Serpopovici163/HYDRA_HARDWARE/connector_type_and_what_board_has_them.txt

Picoblade connectors (all connector types should only be used for one pinout to avoid issues from being able to connect the wrong things together)

2p --> V4 NAV (ACT BUS) AND V4 RECOVERY (SFTY SWITCH)
3p -->
4p --> V4 POWER (CELL SENSE)
5p --> V4 POWER (EMAG+INH SW)
6p --> V4 RECOVERY (PYRO)
7p -->* V4 LINK (AUX RADIO)
8p -->* V4 LINK (AUX BATT + ETH)
9p -->
