Serpopovici163/HYDRA_HARDWARE/HYDRA_V4_POWER/STM32G473RET6_PINOUT.xlsx

 |  |  |  |  |  |  |  | HYDRA_V4_POWER
PIN NUM | PIN NAME | SPI | UART | CAN | ADC | GPIO | MAX V | SERCOM I/O | ANALOG I/O | GPIO
2 | PC13 |  |  |  |  | X | 5 |  | INT_VCC_V_SENSE
8 | PC0 |  | LPUART1_RX |  | X | X | 5 |  | INT_3V3_V_SENSE
9 | PC1 |  | LPUART1_TX |  | X | X | 3.6 |  | M2_I_SENSE
10 | PC2 |  |  |  | X | X | 5 |  | M1_I_SENSE
11 | PC3 |  |  |  | X | X | 3.6 |  | M1_V_SENSE
12 | PA0 |  |  |  | X | X | 3.6 |  | M2_V_SENSE
13 | PA1 |  |  |  | X | X | 3.6 |  | M1_OC_FAULT
14 | PA2 |  | USART2_TX |  | X | X | 5 |  | M3_I_SENSE
17 | PA3 |  | USART2_RX |  | X | X | 3.6 |  |  | MCU_R_LED
18 | PA4 | SPI1/3_NSS |  |  | X | X | 3.6 |  |  | MCU_G_LED
19 | PA5 | SPI1_SCLK |  |  | X | X | 3.6
20 | PA6 | SPI1_MISO |  |  | X | X | 3.6
21 | PA7 | SPI1_MOSI |  |  | X | X | 3.6
22 | PC4 |  | USART1_TX |  | X | X | 5 |  | 3V3_V_SENSE
23 | PC5 |  | USART1_RX |  | X | X | 3.6 |  | 5V_V_SENSE
24 | PB0 |  |  |  | X | X | 3.6
25 | PB1 |  |  |  | X | X | 3.6
26 | PB2 |  |  |  | X | X | 3.6
30 | PB10 |  | USART3_TX |  |  | X | 3.6 |  |  | ADC_nRST
33 | PB11 |  | USART3_RX |  | X | X | 3.6 |  | LS_IMON_0
34 | PB12 | SPI2_NSS |  | FDCAN2_RX | X | X | 3.6 | ADC_nCS
35 | PB13 | SPI2_SCLK |  | FDCAN2_TX | X | X | 3.6 | TCAN1146_SCLK
36 | PB14 | SPI2_MISO |  |  | X | X | 3.6 | TCAN1146_MISO
37 | PB15 | SPI2_MOSI |  |  | X | X | 3.6 | TCAN1146_MOSI
38 | PC6 |  |  |  | X | X | 5 |  |  | TCAN1146_nCS
39 | PC7 |  |  |  | X | X | 5
40 | PC8 |  |  |  | X | X | 5 |  |  | LS_PG_0
41 | PC9 |  |  |  | X | X | 5 |  | LS_IMON_1
42 | PA8 |  |  | FDCAN3_RX | X | X | 5 |  |  | LS_PG_1
43 | PA9 |  |  |  | X | X | 5 |  |  | LS_PG_2
44 | PA10 | SPI2_MISO | USART1_RX |  |  | X | 5 |  | LS_IMON_2
45 | PA11 | SPI2_MOSI |  | FDCAN1_RX |  | X | 5 | TCAN1146_RX
46 | PA12 |  |  | FDCAN1_TX |  | X | 5 | TCAN1146_TX
49 | PA13 | SWDIO |  |  |  |  | 5
50 | PA14 | SWCLK |  |  |  |  | 5
51 | PA15 | SPI1/3_NSS | USART2_RX | FDCAN3_TX |  | X | 5 |  |  | EMAG
52 | PC10 | SPI3_SCLK | USART3/4_TX |  |  | X | 5 |  |  | FORCE ON
53 | PC11 | SPI3_MISO | USART3/4_RX |  |  | X | 5 |  |  | CUR_TRIP_RST
54 | PC12 | SPI3_MOSI | UART5_TX |  |  | X | 5 |  |  | M3_INH
55 | PD2 |  | UART5_RX |  |  | X | 5 |  |  | M2_INH
56 | PB3 | SWO |  |  |  |  | 5
57 | PB4 | SPI1/3_MISO | USART2_RX | FDCAN3_TX |  | X | 5 |  |  | STAT_nPG
58 | PB5 | SPI1/3_MOSI |  | FDCAN2_RX |  | X | 5 | TCAN330_RX
59 | PB6 |  | USART1_TX | FDCAN2_TX |  | X | 5 | TCAN330_TX
60 | PB7 |  | USART1_RX |  |  | X | 5 |  |  | 3V3_EN
61 | PB8 |  | USART3_RX | FDCAN1_RX |  | X | 5 |  |  | 5V_EN
62 | PB9 |  | USART3_TX | FDCAN1_TX |  | X | 5 |  |  | M1_INH
