Serpopovici163/HYDRA_HARDWARE/HYDRA_V4_NAV/STM32H730_PINOUT.xlsx

PIN NUM | PIN NAME | SDMMC1 | SDMMC2 | DCMI | ADC | GPIO | HYDRA_V4_NAV
1 | PE2 |  |  |  |  | X | BARO_SCLK
2 | PE3 |  |  |  |  | X | BARO0_nCS
3 | PE4 |  |  | D4 |  | X | BARO1_nCS
4 | PE5 |  |  | D6 |  | X | BARO_MISO
5 | PE6 |  |  | D7 |  | X | BARO_MOSI
6 | VBAT |  |  |  |  | X
7 | PC13 |  |  |  |  | X | ACT_PWR_INH
8 | OSC32_IN |  |  |  |  | X
9 | OSC32_OUT |  |  |  |  | X
10 | VSS |  |  |  |  | X
11 | VDD |  |  |  |  | X
12 | OSC_IN |  |  |  |  | X
13 | OSC_OUT |  |  |  |  | X
14 | nRST |  |  |  |  | X
15 | PC0 |  |  |  | X | X | NAV_G_LED
16 | PC1 |  | CK |  | X | X | NAV_R_LED
17 | PC2_C |  |  |  | X | X
18 | PC3_C |  |  |  | X | X | 3V3_V_SENSE
19 | VSSA |  |  |  |  | X
20 | VREF+ |  |  |  |  | X
21 | VDDA |  |  |  |  | X
22 | PA0 |  | CMD |  | X | X | MCU_G_LED
23 | PA1 |  |  |  | X | X | MCU_R_LED
24 | PA2 |  |  |  | X | X
25 | PA3 |  |  |  | X | X
26 | VSS |  |  |  |  | X
27 | VDD |  |  |  |  | X
28 | PA4 |  |  | HSYNC | X | X | IMU1_nCS
29 | PA5 |  |  |  | X | X | IMU_SCLK
30 | PA6 |  |  | PIXCLK | X | X | IMU_MISO
31 | PA7 |  |  |  | X | X | IMU_MOSI
32 | PC4 |  | CKIN |  | X | X | ACT_PWR_V_SENSE
33 | PC5 |  |  |  | X | X | ACT_PWR_IMON
34 | PB0 |  |  |  | X | X | 3V3_IMON
35 | PB1 |  |  |  | X | X | HYDRA_VCC_V_SENSE
36 | PB2 |  |  |  |  | X
37 | PE7 |  |  |  |  | X
38 | PE8 |  |  |  |  | X
39 | PE9 |  |  |  |  | X
40 | PE10 |  |  |  |  | X
41 | PE11 |  |  |  |  | X
42 | PE12 |  |  |  |  | X
43 | PE13 |  |  |  |  | X
44 | PE14 |  |  |  |  | X
45 | PE15 |  |  |  |  | X
46 | PB10 |  |  |  |  | X
47 | PB11 |  |  |  |  | X
48 | VCAP |  |  |  |  | X
49 | VSS |  |  |  |  | X
50 | VDD |  |  |  |  | X
51 | PB12 |  |  |  |  | X | TCAN_nCS
52 | PB13 | D0 |  |  |  | X | TCAN_SCLK
53 | PB14 |  | D0 |  |  | X | TCAN_MISO
54 | PB15 |  | D1 |  |  | X | TCAN_MOSI
55 | PD8 |  |  |  |  | X
56 | PD9 |  |  |  |  | X
57 | PD10 |  |  |  |  | X
58 | PD11 |  |  |  |  | X
59 | PD12 |  |  | D12 |  | X | CAN3_RX
60 | PD13 |  |  | D13 |  | X | CAN3_TX
61 | PD14 |  |  |  |  | X
62 | PD15 |  |  |  |  | X
63 | PC6 | D0DIR/D6 | D6 | D0 |  | X
64 | PC7 | D123DIR/D7 | D7 | D1 |  | X
65 | PC8 | D0 |  | D2 |  | X | SD_D0
66 | PC9 | D1 |  | D3 |  | X | SD_D1
67 | PA8 |  |  |  |  | X
68 | PA9 |  |  | D0 |  | X
69 | PA10 |  |  | D1 |  | X
70 | PA11 |  |  |  |  | X | CAN1_RX
71 | PA12 |  |  |  |  | X | CAN1_TX
72 | SWDIO/PA13 |  |  |  |  | X
73 | VCAP |  |  |  |  | X
74 | VSS |  |  |  |  | X
75 | VDD |  |  |  |  | X
76 | SWCLK/PA14 |  |  |  |  | X
77 | PA15 |  |  |  |  | X
78 | PC10 | D2 |  | D8 |  | X | SD_D2
79 | PC11 | D3 |  | D4 |  | X | SD_D3
80 | PC12 | CK |  | D9 |  | X | SD_CK
81 | PD0 |  |  |  |  | X
82 | PD1 |  |  |  |  | X
83 | PD2 | CMD |  | D11 |  | X | SD_CMD
84 | PD3 |  |  | D5 |  | X | IMU0_ODR
85 | PD4 |  |  |  |  | X | IMU0_Nrst
86 | PD5 |  |  |  |  | X | SD_CD
87 | PD6 |  | CK | D10 |  | X | IMU0_nCS
88 | PD7 |  | CMD |  |  | X | IMU1_INT1
89 | SWO/PB3 |  | D2 |  |  | X
90 | PB4 |  | D3 |  |  | X | IMU1_INT2
91 | PB5 |  |  | D10 |  | X | CAN2_RX
92 | PB6 |  |  | D5 |  | X | CAN2_TX
93 | PB7 |  |  | VSYNC |  | X | GPS_nRST
94 | BOOT
95 | PB8 | CKIN/D4 | D4 | D6 |  | X | GPS_RX
96 | PB9 | CDIR/D5 | D5 | D7 |  | X | GPS_TX
97 | PE0 |  |  | D2 |  | X | GPS_ENABLE
98 | PE1 |  |  | D3 |  | X
99 | VSS |  |  |  |  | X
100 | VDD |  |  |  |  | X
