Serpopovici163/HYDRA_HARDWARE/HYDRA_V4_RECOVERY/STM32H730_PINOUT.xlsx

PIN NUM | PIN NAME | SDMMC1 | SDMMC2 | DCMI | ADC | GPIO | HYDRA_V4_RECOVERY
1 | PE2 |  |  |  |  | X
2 | PE3 |  |  |  |  | X
3 | PE4 |  |  | D4 |  | X
4 | PE5 |  |  | D6 |  | X
5 | PE6 |  |  | D7 |  | X
6 | VBAT |  |  |  |  | X
7 | PC13 |  |  |  |  | X
8 | OSC32_IN |  |  |  |  | X
9 | OSC32_OUT |  |  |  |  | X
10 | VSS |  |  |  |  | X
11 | VDD |  |  |  |  | X
12 | OSC_IN |  |  |  |  | X
13 | OSC_OUT |  |  |  |  | X
14 | nRST |  |  |  |  | X
15 | PC0 |  |  |  | X | X | VCC_V_SENSE
16 | PC1 |  | CK |  | X | X
17 | PC2_C |  |  |  | X | X
18 | PC3_C |  |  |  | X | X | 5V_V_SENSE
19 | VSSA |  |  |  |  | X
20 | VREF+ |  |  |  |  | X
21 | VDDA |  |  |  |  | X
22 | PA0 |  | CMD |  | X | X | 3V3_V_SENSE
23 | PA1 |  |  |  | X | X | PYRO_PWR_V_SENSE
24 | PA2 |  |  |  | X | X | MAIN_V_SENSE
25 | PA3 |  |  |  | X | X | DROGUE_V_SENSE
26 | VSS |  |  |  |  | X
27 | VDD |  |  |  |  | X
28 | PA4 |  |  | HSYNC | X | X | CAM_HSYNC
29 | PA5 |  |  |  | X | X | BUZZER
30 | PA6 |  |  | PIXCLK | X | X | CAM_PIXCLK
31 | PA7 |  |  |  | X | X | DROGUE_I_SENSE
32 | PC4 |  | CKIN |  | X | X | MAIN_I_SENSE
33 | PC5 |  |  |  | X | X | POST_SW_PYRO_V_SENSE
34 | PB0 |  |  |  | X | X | 3V3_IMON
35 | PB1 |  |  |  | X | X | 5V_IMON
36 | PB2 |  |  |  |  | X | MCU_R_LED
37 | PE7 |  |  |  |  | X | MCU_G_LED
38 | PE8 |  |  |  |  | X
39 | PE9 |  |  |  |  | X
40 | PE10 |  |  |  |  | X
41 | PE11 |  |  |  |  | X
42 | PE12 |  |  |  |  | X
43 | PE13 |  |  |  |  | X
44 | PE14 |  |  |  |  | X
45 | PE15 |  |  |  |  | X
46 | PB10 |  |  |  |  | X
47 | PB11 |  |  |  |  | X
48 | VCAP |  |  |  |  | X
49 | VSS |  |  |  |  | X
50 | VDD |  |  |  |  | X
51 | PB12 |  |  |  |  | X
52 | PB13 | D0 |  |  |  | X
53 | PB14 |  | D0 |  |  | X | SD_D0
54 | PB15 |  | D1 |  |  | X | SD_D1
55 | PD8 |  |  |  |  | X
56 | PD9 |  |  |  |  | X
57 | PD10 |  |  |  |  | X
58 | PD11 |  |  |  |  | X
59 | PD12 |  |  | D12 |  | X
60 | PD13 |  |  | D13 |  | X
61 | PD14 |  |  |  |  | X
62 | PD15 |  |  |  |  | X
63 | PC6 | D0DIR/D6 | D6 | D0 |  | X | CAM_D0
64 | PC7 | D123DIR/D7 | D7 | D1 |  | X | CAM_D1
65 | PC8 | D0 |  | D2 |  | X | CAM_D2
66 | PC9 | D1 |  | D3 |  | X | CAM_D3
67 | PA8 |  |  |  |  | X
68 | PA9 |  |  | D0 |  | X
69 | PA10 |  |  | D1 |  | X | CAM_nINTRQ
70 | PA11 |  |  |  |  | X
71 | PA12 |  |  |  |  | X
72 | SWDIO/PA13 |  |  |  |  | X
73 | VCAP |  |  |  |  | X
74 | VSS |  |  |  |  | X
75 | VDD |  |  |  |  | X
76 | SWCLK/PA14 |  |  |  |  | X
77 | PA15 |  |  |  |  | X
78 | PC10 | D2 |  | D8 |  | X
79 | PC11 | D3 |  | D4 |  | X | CAM_D4
80 | PC12 | CK |  | D9 |  | X
81 | PD0 |  |  |  |  | X
82 | PD1 |  |  |  |  | X | CAM_nPWRDN
83 | PD2 | CMD |  | D11 |  | X | CAM_nRST
84 | PD3 |  |  | D5 |  | X | CAM_D5
85 | PD4 |  |  |  |  | X
86 | PD5 |  |  |  |  | X
87 | PD6 |  | CK | D10 |  | X | SD_CK
88 | PD7 |  | CMD |  |  | X | SD_CMD
89 | SWO/PB3 |  | D2 |  |  | X | SD_D2
90 | PB4 |  | D3 |  |  | X | SD_D3
91 | PB5 |  |  | D10 |  | X | DROGUE_TRIG
92 | PB6 |  |  | D5 |  | X | MAIN_TRIG
93 | PB7 |  |  | VSYNC |  | X
94 | BOOT
95 | PB8 | CKIN/D4 | D4 | D6 |  | X | CAM_D6
96 | PB9 | CDIR/D5 | D5 | D7 |  | X | CAM_D7
97 | PE0 |  |  | D2 |  | X | IMU_nRST
98 | PE1 |  |  | D3 |  | X | IMU_ODR
99 | VSS |  |  |  |  | X
100 | VDD |  |  |  |  | X
