Serpopovici163/HYDRA_HARDWARE/HYDRA_V4_LINK/Project Outputs for Free Documents/BOM/Bill of Materials-HYDRA_V4_LINK.xlsx

Line # | Quantity | Name | Description | Designator | Revision ID | Revision State | Revision Status | Manufacturer 1 | Manufacturer Part Number 1 | Manufacturer Lifecycle 1 | Supplier 1 | Supplier Part Number 1 | Supplier Unit Price 1 | Supplier Subtotal 1
 | 54 | 100n, TBD, 10u, 3.3n, 6.8n, 22n, 10n, 4.7n, 4.7u, 30p, 1u, 18p | LARGE PADS, 0402 CAP, CHANGE COMMENT TO MATCH REAL P/N | C1, C2, C3, C4, C5, C6, C8, C14, C16, C17, C18, C19, C20, C24, C25, C27, C28, C29, C30, C31, C32, C33, C34, C35, C36, C37, C38, C39, C40, C41, C42, C43, C44, C45, C46, C47, C48, C49, C50, C51, C52, C53, C54, C55, C56, C57, C58, C59, C61, C62, C63, C64, C65, C68 |  | Unknown server |  | Taiyo Yuden | EMK105BJ105KV-F | Volume Production | LCSC | C92755 | 0.0034 | 0.34
 | 3 | C0805C106K8PACTU | CAP CER 10UF 10V X5R 0805 | C7, C9, C10 |  | Unknown server |  | KEMET | C0805C106K8PACTU | Volume Production | Mouser | 80-C0805C106K8P | 0.12 | 0.36
 | 3 | GRM21BR60J226ME39L | Chip Multilayer Ceramic Capacitors for General Purpose, 0805, 22uF, X5R, 15%, 20%, 6.3V | C11, C12, C13 |  | Unknown server |  | Murata | GRM21BR60J226ME39L | Volume Production | Newark | 24R6338 | 0.126 | 0.378
 | 2 | 4TPE100MZB | Molded Tantalum Polymer Capacitor 100uF 20% 4V life 1000Hours SMD 1411 | C15, C26 |  | Unknown server |  | Panasonic | 4TPE100MZB | Volume Production | Newark | 88Y9311 | 1.04 | 2.08
 | 2 | GRM21BR61E226ME44L | Chip Multilayer Ceramic Capacitors for General Purpose, 0805, 22uF, X5R, 15%, 20%, 25V | C21, C22 |  | Unknown server |  | Murata | GRM21BR61E226ME44L | Volume Production | Farnell | 1907510 | 0.07904 | 0.39518
 | 1 | TMK212BBJ106KG-T | Multilayer Ceramic Capacitor 10uF 25V X5R 10% SMD 0805 T/R | C23 |  | Unknown server |  | Taiyo Yuden | TMK212BBJ106KG-T | Volume Production | Newark | 92T9713 | 0.16 | 0.16
 | 3 | MM5Z3V3T1G | Zener Voltage Regulator, 500 mW, 2-Pin SOD-523, Pb-Free, Tape and Reel | D1, D4, D6 |  | Unknown server |  | ON Semiconductor | MM5Z3V3T1G | Volume Production | Newark | 09R9519 | 0.03 | 0.09
 | 4 | 150066RG54050 | Led, Red/Grn, 180Mcd/230Mcd, 624Nm/525Nm Rohs Compliant: Yes | D2, D3, D5, D7 |  | Unknown server
 | 3 | MF-PSML150/12-2 | MF-PSML150/12-2 | F1, F2, F3 |  | Unknown server |  | Bourns | MF-PSMF050X-2 | Volume Production | Newark | 87W5970 | 0.267 | 0.801
 | 1 | BLM15AG121SN1D | Chip Ferrite Bead, 0402, 120Ω @ 100MHz, 0.19Ω, 25%, 550mA | FB1 |  | Unknown server |  | Murata | BLM15AG121SN1D | Volume Production | Digikey | 490-1005-1-ND | 0.1 | 0.1
 | 1 | BLM15PX601SN1D | Chip Ferrite Bead, 0402, 600Ω @ 100MHz, 0.23Ω, 25%, 900mA | FB2 |  | Unknown server |  | Murata | BLM15PX601SN1D | Volume Production | Digikey | 490-9657-1-ND | 0.1 | 0.1
 | 2 | SFML-110-02-L-D-A | Board Connector, 20 Contact(s), 2 Row(s), Female, Straight, 0.05 inch Pitch, Surface Mount Terminal, Locking, Black Insulator, Socket | J1, J2 |  | Unknown server |  | Samtec | SFML-110-02-L-D-A | Volume Production
 | 2 | TFML-110-02-L-D-A | Board Connector, 20 Contact(s), 2 Row(s), Male, Straight, Surface Mount Terminal | J3, J4 |  | Unknown server |  | Samtec | TFML-110-02-L-D-A | Volume Production | Avnet | TFML-110-02-L-D-A | 3.24 | 6.49
 | 1 | FTSH-105-01-F-D-RA-K | Board Connector, 10 Contact(s), 2 Row(s), Male, Right Angle, 0.05 inch Pitch, Surface Mount Terminal, Locking, Black Insulator | J5 |  | Unknown server |  | Samtec | FTSH-105-01-F-D-RA-K | Volume Production | Avnet | FTSH-105-01-F-D-RA-K | 2.61 | 2.61
 | 1 | SM08B-GHS-TB(LF)(SN);- | Connector Header, GH Series, 8 Position, 1.25mm, 30-26 AWG, 50V, Surface Mount, Right Angle, Solder, Locking Ramp | J6 |  | Unknown server |  | JST | SM08B-GHS-TB(LF)(SN);- |  | LCSC | C265111 | 0.2261 | 1.13
 | 2 | IHLP1616ABER1R0M01 | Fixed Inductors Commercial High Saturation Series SMT 1uH 4A 52.5mΩ 20% | L1, L2 |  | Unknown server |  | Vishay Dale | IHLP1616ABER1R0M01 | Volume Production | Newark | 45M5848 | 0.391 | 0.782
 | 1 | BSS138W-7-F | N-Channel Enhancement Mode Mosfet, 50 V, 200 mA, -55 to 150 degC, 6-Pin SOT-323, RoHS, Tape and Reel | Q1 |  | Unknown server |  | Diodes | BSS138W-7-F | Volume Production | Future Electronics | 6104898 | 0.161 | 0.161
 | 2 | DMG1013UW-7 | P-Channel Enhancement Mode MOSFET, 310 mW, 20 V, -55 to 150 degC, 3-Pin SOT-323, RoHS, Tape and Reel | Q2, Q4 |  | Unknown server |  | Diodes | DMG1013UW-7 | Volume Production | Mouser | 621-DMG1013UW-7 | 0.24 | 0.48
 | 2 | SSM6N7002KFU,LF | Transistor MOSFET Array Dual N-CH 60V 300mA 6-Pin SOT-363 Emboss T/R | Q3, Q5 |  | Unknown server |  | Toshiba | SSM6N7002KFU,LF | Volume Production | Mouser | 757-SSM6N7002KFULF | 0.2 | 0.4
 | 86 | 1M, 680k, 1k, 68k, 110k, 10k, 100k, 330, 560, 2.7k, 24k, 49.9 1%, 33, 75 1%, 150 1%, 12.4k 1%, 10 1%, 120 | Resistor | R1, R2, R3, R4, R5, R6, R7, R8, R9, R10, R11, R12, R13, R14, R15, R16, R17, R18, R19, R20, R21, R22, R23, R24, R25, R26, R27, R28, R29, R30, R31, R32, R33, R34, R35, R36, R37, R38, R39, R40, R41, R42, R43, R44, R46, R47, R50, R54, R55, R56, R57, R58, R59, R60, R61, R62, R63, R64, R65, R66, R67, R68, R69, R70, R71, R72, R73, R74, R75, R76, R77, R78, R79, R81, R82, R83, R84, R85, R90, R91, R93, R95, R96, R97, R98, R101 |  | Unknown server
 | 1 | 473521001 | MicroSD(TM), Pitch 1.1 mm, 8 Position, Height 1.88 mm, -20 to 85 degC, RoHS, Tape and Reel | SD1 |  | Unknown server |  | Molex | 47352-1001 | Volume Production
 | 2 | KXT331LHS | SWITCH TACTILE SPST-NO 0.02A 15V | SW2, SW3 |  | Unknown server |  | ITT C&K | KXT331LHS | Volume Production | Newark | 35AH1369 | 0.213 | 0.426
 | 1 | ALANL100X1-DE12DT | Datacom Transformer, LAN; 10/100 BASE-TX; ETHERNET Application(s), 1CT:1CT | T1 |  | Unknown server |  | Abracon | ALANL100X1-DE12DT | Volume Production | Arrow Electronics | ALANL100X1-DE12DT | 2.18 | 2.18
 | 2 | TPS16412DRCR | 2.7-V to 40-V 152-mΩ 1.8-A eFuse with output power limiting 10-VSON -40 to 125 | U1, U2 |  | Unknown server |  | Texas Instruments | TPS16412DRCR |  | Mouser | 595-TPS16412DRCR | 1.46 | 2.92
 | 1 | BQ24040DSQR | 800 mA, Single-Input, Single Cell Li-Ion Battery Charger with Auto Start. Vovp=6.6 V, 3.5 V, -40 to 85 degC, 10-pin SON (DSQ), Green (RoHS & no Sb/Br) | U3 |  | Unknown server |  | Texas Instruments | BQ24040DSQR | Volume Production | Mouser | 595-BQ24040DSQR | 0.75 | 0.75
 | 2 | ACS711KEXLT-15AB-T | Hall Effect Linear Current Sensor with Overcurrent Fault Output for <100 V Isolation Applications, 3 to 5.5 V, -15.5 to 15.5 A IP, -40 to 125 degC, 12-Pin QFN (EX), RoHS, Tape and Reel | U4, U8 |  | Unknown server |  | Allegro MicroSystems | ACS711KEXLT-15AB-T | Volume Production | Arrow Electronics | ACS711KEXLT-15AB-T | 0.8707 | 1.74
 | 1 | TPS63021DSJR | Switching Regulator, Current-mode, 2A, 2600kHz Switching Freq-Max, PDSO14 | U5 |  | Unknown server |  | Texas Instruments | TPS63021DSJR | Volume Production | Newark | 54AH1637 | 1.12 | 1.12
 | 2 | LM66200DRLR | 1.6-V to 5.5-V, 40-mΩ, 2.5-A, low-IQ, dual ideal diode 8-SOT-5X3 -40 to 125 | U6, U10 |  | Unknown server |  | Texas Instruments | LM66200DRLR |  | LCSC | C3235556 | 0.2954 | 0.5908
 | 1 | AiThinker RA-02 LoRa Module |  | U7 |  | Unknown server
 | 1 | TPS62133RGTR | Buck Step Down Regulator with 3 to 17 V Input and 5 V Output, -40 to 85 degC, 16-Pin QFN (RGT), Green (RoHS & no Sb/Br) | U9 |  | Unknown server |  | Texas Instruments | TPS62133RGTR | Volume Production | Digikey | 296-29937-6-ND | 1.71 | 1.71
 | 1 | W5500 | Ethernet CTLR Single Chip 10Mbps/100Mbps 3.3V 48-Pin LQFP Reel | U11 |  | Unknown server |  | WIZnet | W5500 |  | LCSC | C32843 | 3.14 | 3.14
 | 1 | STM32G473RET6TR | MCU 32-Bit STM32 ARM Cortex-M4 RISC 512KB Flash 1.71V to 3.6V 64-Pin LQFP T/R | U12 |  | Unknown server |  | STMicroelectronics | STM32G473RET6TR | Volume Production | Arrow Electronics | STM32G473RET6TR | 4.81 | 4807.2
 | 1 | TCAN1146DYYRQ1 | Automotive CAN FD transceiver with watchdog, bus diagnostics and partial networking via sele 14-SOT-23-THIN -40 to 150 | U13 |  | Unknown server
 | 1 | TCAN330GDCNR | IC TRANSCEIVER 1/1 SOT23-8 | U15 |  | Unknown server |  | Texas Instruments | TCAN330GDCNR | Volume Production | Digikey | 296-TCAN330GDCNRCT-ND | 2.55 | 2.55
 | 2 | ABM8G-25.000MHZ-18-D2Y-T | Crystal 25MHz ±20ppm (Tol) ±30ppm (Stability) 18pF FUND 60Ω 4-Pin SMD T/R | Y1, Y2 |  | Unknown server |  | Abracon | ABM8G-25.000MHZ-18-D2Y-T |  | Farnell | 2101339 | 0.37256 | 0.74513
 | 1 | ECS-.327-12.5-1210-TR | CRYSTAL 32.7680KHZ 12.5PF SMD | Y3 |  | Unknown server |  | ECS International | ECS-.327-12.5-1210-TR | Volume Production | Digikey | XC2282CT-ND | 1.31 | 1.31
