Serpopovici163/HYDRA_HARDWARE/HYDRA_V4_ASSY/Project Outputs for HYDRA_V4_ASSY/HYDRA_V4_ASSY.xlsx

Line # | Name | Description | Designator | Revision ID | Revision State | Revision Status | ModuleAssembly | Quantity | Manufacturer 1 | Manufacturer Part Number 1 | Manufacturer Lifecycle 1 | Supplier 1 | Supplier Part Number 1 | Supplier Unit Price 1 | Supplier Subtotal 1
 | 0402 CAP | LARGE PADS, 0402 CAP, CHANGE COMMENT TO MATCH REAL P/N | C1, C2, C2_FDCAN_1, C2_FDCAN_2, C3, C4, C5, C6, C7, C8, C9, C10, C11, C12, C13, C14, C15, C16, C17, C18, C19, C20, C21, C22, C23, C24, C25, C26, C27, C28, C29, C30, C31, C32, C33, C34, C35, C36, C37, C38, C39, C40, C41, C42, C42_LS_0, C42_LS_1, C42_LS_2, C43, C44, C45, C46, C47, C48, C49, C50, C51, C52, C53, C54, C55, C56, C57, C58, C59, C60, C61, C62, C63, C64, C65, C68 | CMP-001-00058-1 | Draft | Up to date | HYDRA_V4_POWER.PcbDoc, HYDRA_V4_NAV.PcbDoc, HYDRA_V4_LINK_V2.PcbDoc, HYDRA_V4_RECOVERY.PcbDoc | 254 | Taiyo Yuden | EMK105BJ105KV-F | Volume Production | LCSC | C92755 | 0.0037 | 0.9398
 | C0805C106K8PACTU | CAP CER 10UF 10V X5R 0805 | C7, C9, C10 | CMP-2007-03243-2 | New From Design | Up to date | HYDRA_V4_LINK_V2.PcbDoc | 3 | KEMET | C0805C106K8PACTU | Volume Production | Digikey | 399-C0805C106K8PACTUCT-ND | 0.13 | 0.39
 | GRM21BR61E226ME44L | Chip Multilayer Ceramic Capacitors for General Purpose, 0805, 22uF, X5R, 15%, 20%, 25V | C8, C13, C21, C22 | CMP-2007-03222-3 | New From Design | Up to date | HYDRA_V4_POWER.PcbDoc, HYDRA_V4_LINK_V2.PcbDoc | 6 | Murata | GRM21BR61E226ME44L | Volume Production | Digikey | 490-10749-1-ND | 0.187 | 1.87
 | TMK212BBJ106KG-T | Multilayer Ceramic Capacitor 10uF 25V X5R 10% SMD 0805 T/R | C9, C10, C14, C15, C23 | CMP-14477-000079-3 | New From Design | Up to date | HYDRA_V4_POWER.PcbDoc, HYDRA_V4_LINK_V2.PcbDoc | 9 | Taiyo Yuden | TMK212BBJ106KG-T | Volume Production | Digikey | 587-2985-1-ND | 0.082 | 0.82
 | GRM21BR60J226ME39L | Chip Multilayer Ceramic Capacitors for General Purpose, 0805, 22uF, X5R, 15%, 20%, 6.3V | C11, C12, C13 | CMP-2007-03385-2 | New From Design | Up to date | HYDRA_V4_LINK_V2.PcbDoc | 3 | Murata | GRM21BR60J226ME39L | Volume Production | Future Electronics | 1620103 | 0.2 | 0.6
 | GRM188R60J106ME47D | Chip Multilayer Ceramic Capacitors for General Purpose, 0603, 10uF, X5R, 15%, 20%, 6.3V | C12 | CMP-2006-02792-2 | New From Design | Up to date | HYDRA_V4_RECOVERY.PcbDoc | 1 | Murata | GRM188R60J106ME47D | Volume Production | Mouser | 81-GRM188R60J106ME47 | 0.1 | 0.1
 | 4TPE100MZB | Molded Tantalum Polymer Capacitor 100uF 20% 4V life 1000Hours SMD 1411 | C15, C26 | CMP-05428-001141-1 | New From Design | Up to date | HYDRA_V4_LINK_V2.PcbDoc | 2 | Panasonic | 4TPE100MZB | Volume Production | Arrow Electronics | 4TPE100MZB | 0.2892 | 1.45
 | 150066RG54050 | Led, Red/Grn, 180Mcd/230Mcd, 624Nm/525Nm Rohs Compliant: Yes | D1, D2, D3, D4, D5, D6, D7 | CMP-004-00040-2 | Draft | Up to date | HYDRA_V4_POWER.PcbDoc, HYDRA_V4_NAV.PcbDoc, HYDRA_V4_RECOVERY.PcbDoc, HYDRA_V4_LINK_V2.PcbDoc | 20
 | MM5Z3V3T1G | Zener Voltage Regulator, 500 mW, 2-Pin SOD-523, Pb-Free, Tape and Reel | D1, D3, D4, D6, D7, D8, D9, D10 | CMP-1060-00750-1 | Released | Up to date | HYDRA_V4_LINK_V2.PcbDoc, HYDRA_V4_NAV.PcbDoc, HYDRA_V4_RECOVERY.PcbDoc, HYDRA_V4_POWER.PcbDoc | 15 | onsemi | MM5Z3V3T1G | Volume Production | Newark | 09R9519 | 0.03 | 0.45
 | MMSZ5242BT1G | Zener Voltage Regulator, 500 mW, 2-Pin SOD-123, Pb-Free, Tape and Reel | D2 | CMP-1060-00565-1 | Released | Up to date | HYDRA_V4_POWER.PcbDoc | 2 | onsemi | MMSZ5242BT1G | Volume Production | Newark | 58M9232 | 0.022 | 0.044
 | MBRA140T3G | Schottky Power Rectifier, 2-Pin SMA, Pb-Free, Tape and Reel | D3 | CMP-1055-00320-1 | Released | Up to date | HYDRA_V4_RECOVERY.PcbDoc | 1 | onsemi | MBRA140T3G | Volume Production | Newark | 83H7266 | 0.125 | 0.125
 | 0466005.NR | FUSE BOARD MNT 5A 32VAC/VDC 1206 | F1 | CMP-08605-000032-1 | New From Design | Up to date | HYDRA_V4_NAV.PcbDoc | 1 | Littelfuse | 0466005.NR | Volume Production | Arrow Electronics | 0466005.NR | 0.2973 | 0.2973
 | 0501010.WR | FUSE BOARD MOUNT 10A 32VDC 1206 | F1, F2 | CMP-08605-000084-1 | New From Design | Up to date | HYDRA_V4_POWER.PcbDoc | 4 | Littelfuse | 0501010.WR | Volume Production | Arrow Electronics | 0501010.WR | 0.5465 | 2.19
 | MF-PSMF010X-2 | PTC RESET FUSE 15V 100MA 0805 | F1, F2 | CMP-07400-000017-1 | New From Design | Up to date | HYDRA_V4_RECOVERY.PcbDoc | 2 | Bourns | MF-PSMF010X-2 | Volume Production | Newark | 87W5967 | 0.225 | 0.45
 | MF-PSMF050X-2 | PTC RESET FUSE 6V 500MA 0805 | F1, F2, F3, F7, F8 | CMP-07400-000013-1 | New From Design | Up to date | HYDRA_V4_LINK_V2.PcbDoc, HYDRA_V4_POWER.PcbDoc | 9 | Bourns | MF-PSMF050X-2 | Volume Production | Newark | 87W5970 | 0.267 | 2.4
 | 0603L010YR | PTC RESET FUSE 15V 100MA 0603 | F2, F6 | CMP-08606-000025-1 | New From Design | Up to date | HYDRA_V4_NAV.PcbDoc, HYDRA_V4_RECOVERY.PcbDoc | 2 | Littelfuse | 0603L010YR | Volume Production | Mouser | 576-0603L010YR | 1.22 | 2.44
 | MF-FSMF050X-2 | PTC RESET FUSE 6V 500MA 0603 | F3, F4 | CMP-07400-000010-1 | New From Design | Up to date | HYDRA_V4_RECOVERY.PcbDoc | 2 | Bourns | MF-FSMF050X-2 | Volume Production | Mouser | 652-MFFSMF050X-2 | 0.4 | 0.8
 | 0805L010YR | 0805L010YR PTC Resettable Fuse 0.1A(hold) 0.3A(trip) 15VDC 100A 0.5W 1.5s 1Ohm SMD Solder Pad 0805 T/R | F4 | CMP-00227-00673855-1 | New From Design | Up to date | HYDRA_V4_POWER.PcbDoc | 2 | Littelfuse | 0805L010YR | Volume Production | Newark | 18M4774 | 0.383 | 0.766
 | 0ZCK0010FF2G | PTC RESET FUSE 15V 100MA 0805 | F5, F6 | CMP-16043-000017-1 | New From Design | Up to date | HYDRA_V4_POWER.PcbDoc | 4 | Bel | 0ZCK0010FF2G | Volume Production | Arrow Electronics | 0ZCK0010FF2G | 0.074 | 0.296
 | MF-NSMF012-2 | PTC RESET FUSE 30V 120MA 1206 | F7 | CMP-07400-000025-1 | New From Design | Up to date | HYDRA_V4_RECOVERY.PcbDoc | 1 | Bourns | MF-NSMF012-2 | Volume Production | Newark | 89M6030 | 0.259 | 0.259
 | BLM15AG121SN1D | Chip Ferrite Bead, 0402, 120Ω @ 100MHz, 0.19Ω, 25%, 550mA | FB1 | CMP-0686-00170-4 | New From Design | Up to date | HYDRA_V4_LINK_V2.PcbDoc | 1 | Murata | BLM15AG121SN1D | Volume Production | Newark | 73M9023 | 0.006 | 0.006
 | BLM15PX601SN1D | Chip Ferrite Bead, 0402, 600Ω @ 100MHz, 0.23Ω, 25%, 900mA | FB1, FB2 | CMP-0686-00252-4 | New From Design | Up to date | HYDRA_V4_POWER.PcbDoc, HYDRA_V4_NAV.PcbDoc, HYDRA_V4_RECOVERY.PcbDoc, HYDRA_V4_LINK_V2.PcbDoc | 5 | Murata | BLM15PX601SN1D | Volume Production | Digikey | 490-9657-1-ND | 0.1 | 0.5
 | SFML-110-02-L-D-A | Board Connector, 20 Contact(s), 2 Row(s), Female, Straight, 0.05 inch Pitch, Surface Mount Terminal, Locking, Black Insulator, Socket | J1, J2 | CMP-002-00043-1 | Draft | Up to date | HYDRA_V4_POWER.PcbDoc, HYDRA_V4_NAV.PcbDoc, HYDRA_V4_LINK_V2.PcbDoc, HYDRA_V4_RECOVERY.PcbDoc | 10 | Samtec | SFML-110-02-L-D-A | Volume Production | Digikey | SAM11753-ND | 5.64 | 56.4
 | 205338-0004 | PICO-LOCK 2.0 W/B HEADER ASSY ET | J3 | CMP-04776-000717-1 | New From Design | Up to date | HYDRA_V4_NAV.PcbDoc | 1 | Molex | 205338-0004 | Volume Production | Mouser | 538-205338-0004 | 1.67 | 1.67
 | XT30PW-M |  | J3 | CMP-002-00064-1 | Draft | Up to date | HYDRA_V4_POWER.PcbDoc | 2 | Amass | XT30PW-M | Unknown
 | SM06B-GHS-TB(LF)(SN) | Conn Shrouded Header HDR 6 POS 1.25mm Solder RA Side Entry SMD T/R | J3, J4 | CMP-002-00082-1 | Draft | Up to date | HYDRA_V4_RECOVERY.PcbDoc | 2 | JST | SM06B-GHS-TB(LF)(SN) | Unknown | LCSC | C133065 | 0.1908 | 0.954
 | TFML-110-02-L-D-A | Board Connector, 20 Contact(s), 2 Row(s), Male, Straight, Surface Mount Terminal | J3, J4, J5, J6, J7 | CMP-002-00042-3 | Draft | Up to date | HYDRA_V4_LINK_V2.PcbDoc, HYDRA_V4_POWER.PcbDoc, HYDRA_V4_NAV.PcbDoc, HYDRA_V4_RECOVERY.PcbDoc | 10 | Samtec | TFML-110-02-L-D-A | Volume Production | Arrow Electronics | TFML-110-02-L-D-A | 3.31 | 33.1
 | FTSH-105-01-F-D-RA-K | Board Connector, 10 Contact(s), 2 Row(s), Male, Right Angle, 0.05 inch Pitch, Surface Mount Terminal, Locking, Black Insulator | J5, J6, J11 | CMP-002-00041-5 | Draft | Up to date | HYDRA_V4_LINK_V2.PcbDoc, HYDRA_V4_POWER.PcbDoc, HYDRA_V4_NAV.PcbDoc, HYDRA_V4_RECOVERY.PcbDoc | 5 | Samtec | FTSH-105-01-F-D-RA-K | Volume Production | Avnet | FTSH-105-01-F-D-RA-K | 2.63 | 13.17
 | SM02B-GHS-TB(LF)(SN) | MCU 32-bit LPC1800 ARM Cortex M3 RISC 768KB Flash 3.3V 100-Pin TFBGA Tray | J5, J8 | CMP-002-00083-1 | Draft | Up to date | HYDRA_V4_RECOVERY.PcbDoc, HYDRA_V4_NAV.PcbDoc | 2 | JST | SM02B-GHS-TB(LF)(SN) | Unknown | LCSC | C189893 | 0.1022 | 0.511
 | SM08B-GHS-TB(LF)(SN);- | Connector Header, GH Series, 8 Position, 1.25mm, 30-26 AWG, 50V, Surface Mount, Right Angle, Solder, Locking Ramp | J6 | CMP-002-00079-3 | Draft | Up to date | HYDRA_V4_LINK_V2.PcbDoc | 1 | JST | SM08B-GHS-TB(LF)(SN);- | Unknown | LCSC | C265111 | 0.2964 | 1.48
 | SM05B-GHS-TB(LF)(SN) | Connector Header, GH Series, 5 Position, 1.25mm, Surface Mount, Right Angle, Tin, Natural | J7 | CMP-002-00081-1 | Draft | Up to date | HYDRA_V4_POWER.PcbDoc | 2 | JST | SM05B-GHS-TB(LF)(SN) | Unknown | Mouser | 306-SM05BGHSTBLFSN | 0.42 | 0.84
 | U.FL-R-SMT(10) | CONN U.FL RCPT STR 50 OHM SMD | J7 | CMP-0029-00003-2 | New From Design | Up to date | HYDRA_V4_NAV.PcbDoc | 1 | Hirose | U.FL-R-SMT(10) | Volume Production | Newark | 69AK2346 | 0.884 | 0.884
 | SM04B-GHS-TB(LF)(SN) | Conn Shrouded Header HDR 4 POS 1.25mm Solder RA SMD Reel | J8 | CMP-002-00080-1 | Draft | Up to date | HYDRA_V4_POWER.PcbDoc | 2 | JST | SM04B-GHS-TB(LF)(SN) | Unknown | LCSC | C189895 | 0.1394 | 0.697
 | LQW18AN27NJ00D | Wire Wound RF Inductor 27nH ±5% 440mA 0.21Ω 0603 (1608) | L1 | CMP-06042-013840-1 | New From Design | Up to date | HYDRA_V4_NAV.PcbDoc | 1 | Murata | LQW18AN27NJ00D | Volume Production | Mouser | 81-LQW18AN27NJ00D | 0.11 | 0.11
 | IHLP1212BZER2R2M11 | FIXED IND 2.2UH 3A 46 MOHM SMD | L1, L2 | CMP-02424-000689-1 | New From Design | Up to date | HYDRA_V4_POWER.PcbDoc | 4 | Vishay Dale | IHLP1212BZER2R2M11 | Volume Production | Mouser | 70-IHLP1212BZER2R2M1 | 1.06 | 4.24
 | IHLP1616ABER1R0M01 | Fixed Inductors Commercial High Saturation Series SMT 1uH 4A 52.5mΩ 20% | L1, L2 | CMP-02424-000161-1 | New From Design | Up to date | HYDRA_V4_LINK_V2.PcbDoc | 2 | Vishay Dale | IHLP1616ABER1R0M01 | Volume Production | Arrow Electronics | IHLP1616ABER1R0M01 | 0.5726 | 1.15
 | CMT-8504-100-SMT-TR | 8.5 mm, 5 Vo-p, 100 dB, Surface Mount (SMT), Magnetic Audio Transducer Buzzer | LS1 | CMP-00030-00002-1 | Draft | Up to date | HYDRA_V4_RECOVERY.PcbDoc | 1 | Same Sky | CMT-8504-100-SMT-TR | Volume Production | Mouser | 490-CMT-8504100SMTTR | 1.4 | 1.4
 | SISH615ADN-T1-GE3 | Trans MOSFET P-CH 20V 22.1A 8-Pin PowerPAK 1212 EP T/R | Q1, Q2, Q3, Q4, Q5, Q6, Q7, Q11, Q18, Q19 | CMP-013-00018-2 | Draft | Up to date | HYDRA_V4_POWER.PcbDoc, HYDRA_V4_RECOVERY.PcbDoc | 22
 | BSS138W-7-F | N-Channel Enhancement Mode Mosfet, 50 V, 200 mA, -55 to 150 degC, 6-Pin SOT-323, RoHS, Tape and Reel | Q1, Q2, Q4, Q10, Q12 | CMP-2000-05968-1 | Released | Up to date | HYDRA_V4_LINK_V2.PcbDoc, HYDRA_V4_NAV.PcbDoc, HYDRA_V4_RECOVERY.PcbDoc, HYDRA_V4_POWER.PcbDoc | 6 | Diodes | BSS138W-7-F | Volume Production | Future Electronics | 6104898 | 0.161 | 0.966
 | DMG1013UW-7 | P-Channel Enhancement Mode MOSFET, 310 mW, 20 V, -55 to 150 degC, 3-Pin SOT-323, RoHS, Tape and Reel | Q2, Q4, Q7, Q8, Q9, Q13, Q14, Q17 | CMP-2000-06170-1 | Released | Up to date | HYDRA_V4_LINK_V2.PcbDoc, HYDRA_V4_POWER.PcbDoc, HYDRA_V4_NAV.PcbDoc, HYDRA_V4_RECOVERY.PcbDoc | 14 | Diodes | DMG1013UW-7 | Volume Production | Digikey | DMG1013UW-7DICT-ND | 0.168 | 2.35
 | SSM6N7002KFU,LF | MOSFET 2N-CH 60V 0.3A | Q2, Q9, Q10, Q16 | CMP-35916-000009-1 | New From Design | Up to date | HYDRA_V4_RECOVERY.PcbDoc, HYDRA_V4_POWER.PcbDoc | 7 | Toshiba | SSM6N7002KFU,LF | Volume Production | Arrow Electronics | SSM6N7002KFU,LF | 0.0131 | 0.131
 | SSM6N7002KFU,LF | Transistor MOSFET Array Dual N-CH 60V 300mA 6-Pin SOT-363 Emboss T/R | Q3, Q5 | CMP-006-0005-1 | Draft | Up to date | HYDRA_V4_LINK_V2.PcbDoc | 2 | Toshiba | SSM6N7002KFU,LF | Volume Production | Arrow Electronics | SSM6N7002KFU,LF | 0.0131 | 0.131
 | FDC6327C | Dual N & P-Channel 2.5 V Specified PowerTrench(TM) MOSFET, -55 to 150 degC, 6-Pin SOT-23, RoHS, Tape and Reel | Q15 | CMP-2000-04939-1 | Released | Up to date | HYDRA_V4_POWER.PcbDoc | 2 | onsemi | FDC6327C | Volume Production | Mouser | 512-FDC6327C | 1.26 | 2.52
 | Resistor | Resistor | R1, R2, R3, R3_FDCAN_1, R3_FDCAN_2, R4, R5, R6, R7, R8, R9, R10, R11, R12, R13, R14, R15, R16, R17, R18, R19, R20, R21, R22, R23, R24, R25, R26, R27, R28, R29, R30, R31, R32, R33, R34, R35, R36, R37, R38, R39, R40, R41, R42, R43, R44, R45, R46, R47, R48, R49, R50, R51, R52, R53, R54, R55, R56, R57, R58, R59, R60, R61, R62, R63, R64, R65, R66, R67, R68, R69, R70, R71, R72, R73, R74, R75, R76, R77, R78, R79, R80, R81, R82, R83, R84, R85, R86, R87, R88, R89, R90, R91, R93, R95, R96, R96_LS_0, R96_LS_1, R96_LS_2, R97, R97_LS_0, R97_LS_1, R97_LS_2, R98, R98_LS_0, R98_LS_1, R98_LS_2, R99_LS_0, R99_LS_1, R99_LS_2, R100_LS_0, R100_LS_1, R100_LS_2, R101, R101_LS_0, R101_LS_1, R101_LS_2, R102_LS_0, R102_LS_1, R102_LS_2 | CMP-009-00002-14 | Draft | Up to date | HYDRA_V4_POWER.PcbDoc, HYDRA_V4_NAV.PcbDoc, HYDRA_V4_LINK_V2.PcbDoc, HYDRA_V4_RECOVERY.PcbDoc | 432
 | 0402 JUMPER | READ THE NAME | R17, R46, R48, R82 | CMP-009-00118-2 | Draft | Up to date | HYDRA_V4_NAV.PcbDoc, HYDRA_V4_RECOVERY.PcbDoc | 4
 | WSLP1206R0100FEA | RES 0.01 OHM 1% 1W 1206 | R26 | CMP-2003-04373-2 | Released | Up to date | HYDRA_V4_POWER.PcbDoc | 2 | Vishay Dale | WSLP1206R0100FEA | Volume Production | Newark | 84R1939 | 0.419 | 0.838
 | 47219-2001 | MicroSD Card Connector, Hinge Type, -40 to 85 degC, 8-Pin SMD, RoHS, Tape and Reel | SD1 | CMP-2000-05245-1 | Released | Up to date | HYDRA_V4_RECOVERY.PcbDoc | 1 | Molex | 47219-2001 | Volume Production | Arrow Electronics | 47219-2001 | 0.9028 | 0.9028
 | 473521001 | MicroSD(TM), Pitch 1.1 mm, 8 Position, Height 1.88 mm, -20 to 85 degC, RoHS, Tape and Reel | SD1 | CMP-2000-05848-1 | Released | Up to date | HYDRA_V4_NAV.PcbDoc, HYDRA_V4_LINK_V2.PcbDoc | 2 | Molex | 47352-1001 | Volume Production
 | KXT331LHS | SWITCH TACTILE SPST-NO 0.02A 15V | SW1, SW2, SW3 | CMP-10040-000029-1 | New From Design | Up to date | HYDRA_V4_POWER.PcbDoc, HYDRA_V4_NAV.PcbDoc, HYDRA_V4_RECOVERY.PcbDoc, HYDRA_V4_LINK_V2.PcbDoc | 12 | ITT C&K | KXT331LHS | Volume Production | Newark | 35AH1369 | 0.213 | 2.56
 | ALANL100X1-DE12DT | Datacom Transformer, LAN; 10/100 BASE-TX; ETHERNET Application(s), 1CT:1CT | T1 | CMP-012-00013-1 | Draft | Up to date | HYDRA_V4_LINK_V2.PcbDoc | 1 | Abracon | ALANL100X1-DE12DT | Volume Production | Digikey | 535-ALANL100X1-DE12DTCT-ND | 2.26 | 2.26
 | TPAD6R | Test Point .6mm | TP13 | CMP-00025-2 | Draft | Out of date | HYDRA_V4_NAV.PcbDoc | 1
 | TPS16412DRCR | 2.7-V to 40-V 152-mΩ 1.8-A eFuse with output power limiting 10-VSON -40 to 125 | U1, U2, U3, U11 | CMP-019-00048-3 | Draft | Up to date | HYDRA_V4_LINK_V2.PcbDoc, HYDRA_V4_NAV.PcbDoc, HYDRA_V4_RECOVERY.PcbDoc | 5 | Texas Instruments | TPS16412DRCR | Unknown | Mouser | 595-TPS16412DRCR | 1.46 | 7.3
 | ACS711KEXLT-15AB-T | Hall Effect Linear Current Sensor with Overcurrent Fault Output for <100 V Isolation Applications, 3 to 5.5 V, -15.5 to 15.5 A IP, -40 to 125 degC, 12-Pin QFN (EX), RoHS, Tape and Reel | U1, U2, U4, U8 | CMP-1557-00001-1 | Released | Up to date | HYDRA_V4_POWER.PcbDoc, HYDRA_V4_RECOVERY.PcbDoc, HYDRA_V4_LINK_V2.PcbDoc | 8 | Allegro MicroSystems | ACS711KEXLT-15AB-T | Volume Production | Arrow Electronics | ACS711KEXLT-15AB-T | 0.8707 | 6.97
 | STM32H730VBT6 | IC MCU 32BIT 128KB FLASH 100LQFP | U1, U8 | CMP-12105-000107-1 | New From Design | Up to date | HYDRA_V4_NAV.PcbDoc, HYDRA_V4_RECOVERY.PcbDoc | 2 | STMicroelectronics | STM32H730VBT6 | Volume Production | Arrow Electronics | STM32H730VBT6 | 6.86 | 13.72
 | TCAN330GDCNR | IC TRANSCEIVER 1/1 SOT23-8 | U2_FDCAN_1, U2_FDCAN_2, U9, U10, U15 | CMP-04872-000178-1 | New From Design | Up to date | HYDRA_V4_NAV.PcbDoc, HYDRA_V4_RECOVERY.PcbDoc, HYDRA_V4_POWER.PcbDoc, HYDRA_V4_LINK_V2.PcbDoc | 6 | Texas Instruments | TCAN330GDCNR | Volume Production | Digikey | 296-TCAN330GDCNRCT-ND | 2.55 | 15.3
 | BQ24040DSQR | 800 mA, Single-Input, Single Cell Li-Ion Battery Charger with Auto Start. Vovp=6.6 V, 3.5 V, -40 to 85 degC, 10-pin SON (DSQ), Green (RoHS & no Sb/Br) | U3 | CMP-0321-00456-2 | Released | Up to date | HYDRA_V4_LINK_V2.PcbDoc | 1 | Texas Instruments | BQ24040DSQR | Volume Production | Digikey | 296-37142-1-ND | 0.78 | 0.78
 | TLV1805DBVR | 40V, RAIL-TO-RAIL INPUT, PUSH-PU | U3 | CMP-04896-000098-1 | New From Design | Up to date | HYDRA_V4_POWER.PcbDoc | 2 | Texas Instruments | TLV1805DBVR | Volume Production | Arrow Electronics | TLV1805DBVR | 0.4046 | 0.8092
 | ACS711KEXLT-31AB-T | Hall Effect Linear Current Sensor with Overcurrent Fault Output for <100 V Isolation Applications, 3 to 5.5 V, -31 to 31 A IP, -40 to 125 degC, 12-Pin QFN (EX), RoHS, Tape and Reel | U4 | CMP-1557-00002-1 | Released | Up to date | HYDRA_V4_POWER.PcbDoc | 2 | Allegro MicroSystems | ACS711KEXLT-31AB-T | Volume Production | Arrow Electronics | ACS711KEXLT-31AB-T | 0.6055 | 1.21
 | MMC5633NJL | Magnetoresistive Sensor X, Y, Z Axis 4-WLP (0.85x0.85) | U4 | CMP-010-00014-2 | Draft | Up to date | HYDRA_V4_NAV.PcbDoc | 1 | Memsic | MMC5633NJL | Unknown | Digikey | 1267-MMC5633NJLCT-ND | 0.96 | 0.96
 | IIM-20670 | 6-axis IMU with extended temperature range and high VRE performance | U4, U8 | CMP-010-00029-4 | Draft | Up to date | HYDRA_V4_RECOVERY.PcbDoc, HYDRA_V4_NAV.PcbDoc | 2 | TDK InvenSense | IIM-20670 | Unknown | Arrow Electronics | IIM-20670 | 8.85 | 17.7
 | AP7375-33SA-7 | LDO Regulator Pos 3.3V 0.3A 3-Pin SOT-23 T/R | U5 | CMP-019-00039-1 | Draft | Up to date | HYDRA_V4_POWER.PcbDoc | 2 | Diodes | AP7375-33SA-7 | Unknown | Mouser | 621-AP7375-33SA-7 | 0.25 | 0.5
 | TPS63021DSJR | Switching Regulator, Current-mode, 2A, 2600kHz Switching Freq-Max, PDSO14 | U5 | CMP-019-00052-2 | Draft | Up to date | HYDRA_V4_LINK_V2.PcbDoc | 1 | Texas Instruments | TPS63021DSJR | Volume Production | LCSC | C202140 | 1.54 | 1.54
 | MS561101BA03-50 | Barometric Pressure Sensor, with Stainless Steel Cap, 1.8 to 3.6 V, -45 to 85 degC, 8-Pin QFN, RoHS, Tape and Reel | U5, U9 | CMP-2000-05251-1 | Released | Up to date | HYDRA_V4_RECOVERY.PcbDoc, HYDRA_V4_NAV.PcbDoc | 2 | Measurement Specialties | MS561101BA03-50 | Unknown
 | MCP1824T-1802E/OT | 300 mA, Low Voltage, Low Quiescent Current LDO Regulator, 5-Pin SOT-23, Extended Temperature, Tape and Reel | U6 | CMP-0136-00652-1 | Released | Up to date | HYDRA_V4_RECOVERY.PcbDoc | 1 | Microchip | MCP1824T-1802E/OT | Volume Production | Arrow Electronics | MCP1824T-1802E/OT | 0.5166 | 0.5166
 | TPS62133RGTR | Buck Step Down Regulator with 3 to 17 V Input and 5 V Output, -40 to 85 degC, 16-Pin QFN (RGT), Green (RoHS & no Sb/Br) | U6, U9 | CMP-0323-00146-3 | Released | Up to date | HYDRA_V4_POWER.PcbDoc, HYDRA_V4_LINK_V2.PcbDoc | 3 | Texas Instruments | TPS62133RGTR | Volume Production | Mouser | 595-TPS62133RGTR | 1.71 | 5.13
 | LM66200DRLR | 1.6-V to 5.5-V, 40-mΩ, 2.5-A, low-IQ, dual ideal diode 8-SOT-5X3 -40 to 125 | U6, U10 | CMP-019-00049-1 | Draft | Up to date | HYDRA_V4_LINK_V2.PcbDoc | 2 | Texas Instruments | LM66200DRLR | Unknown | Heisener | LM66200DRLR | 0.3133 | 0.6266
 | TCAN1146DYYRQ1 | Automotive CAN FD transceiver with watchdog, bus diagnostics and partial networking via sele 14-SOT-23-THIN -40 to 150 | U6, U10, U11, U13 | CMP-318-000000-2 | Draft | Up to date | HYDRA_V4_NAV.PcbDoc, HYDRA_V4_RECOVERY.PcbDoc, HYDRA_V4_POWER.PcbDoc, HYDRA_V4_LINK_V2.PcbDoc | 5
 | ADV7280WBCPZ | Color Signal Decoder, CMOS | U7 | CMP-015-00015-1 | Draft | Up to date | HYDRA_V4_RECOVERY.PcbDoc | 1 | Analog Devices | ADV7280WBCPZ | Not Recommended for New Design | Newark | 49AK9075 | 13.64 | 13.64
 | AiThinker RA-02 LoRa Module |  | U7 | CMP-021-00000-1 | Draft | Up to date | HYDRA_V4_LINK_V2.PcbDoc | 1
 | TPS62132RGTR | Buck Step Down Regulator with 3 to 17 V Input and 3.3 V Output, -40 to 85 degC, 16-Pin QFN (RGT), Green (RoHS & no Sb/Br) | U7 | CMP-0323-00152-3 | Released | Up to date | HYDRA_V4_POWER.PcbDoc | 2 | Texas Instruments | TPS62132RGTR | Volume Production | Arrow Electronics | TPS62132RGTR | 1.31 | 2.61
 | SN74LVC1G11DCKR | IC GATE AND 1CH 3-INP SC70-6 | U8 | CMP-0859-00482-4 | New From Design | Up to date | HYDRA_V4_POWER.PcbDoc | 2 | Texas Instruments | SN74LVC1G11DCKR | Volume Production | Mouser | 595-SN74LVC1G11DCKR | 0.17 | 0.34
 | STM32G473RET6TR | MCU 32-Bit STM32 ARM Cortex-M4 RISC 512KB Flash 1.71V to 3.6V 64-Pin LQFP T/R | U9, U12 | CMP-020-00020-2 | Draft | Up to date | HYDRA_V4_POWER.PcbDoc, HYDRA_V4_LINK_V2.PcbDoc | 3 | STMicroelectronics | STM32G473RET6TR | Volume Production
 | ICM-45686 | Ultra High-Performance 6-Axis MEMS Motion Sensor | U10 | CMP-010-00035-1 | Draft | Up to date | HYDRA_V4_NAV.PcbDoc | 1 | TDK InvenSense | ICM-45686 | Unknown | LCSC | C22459454 | 3.67 | 3.67
 | MS580301BA01-00 | MINIATURE ALTIMETER MODULE | U11 | CMP-03338-000001-1 | New From Design | Up to date | HYDRA_V4_NAV.PcbDoc | 1 | TE Connectivity | MS580301BA01-00 | Volume Production | Future Electronics | 2058846 | 20.06 | 20.06
 | W5500 | Ethernet CTLR Single Chip 10Mbps/100Mbps 3.3V 48-Pin LQFP Reel | U11 | CMP-015-0000-2 | Draft | Up to date | HYDRA_V4_LINK_V2.PcbDoc | 1 | WIZnet | W5500 | Unknown | LCSC | C32843 | 2.73 | 2.73
 | AP7375-50SA-7 | Ldo Cmos Lowcurr SOT23 T&r 3K | U12 | CMP-019-00041-1 | Draft | Up to date | HYDRA_V4_POWER.PcbDoc | 2 | Diodes | AP7375-50SA-7 | Unknown | Mouser | 621-AP7375-50SA-7 | 0.25 | 0.5
 | MAX-M10M-00B | Gnss Lcc Rx Mod, Rom, Crystal | U12 | CMP-010-00031-2 | Draft | Up to date | HYDRA_V4_NAV.PcbDoc | 1 | u-blox | MAX-M10M-00B | Unknown | Future Electronics | 6161035 | 14.2 | 14.2
 | LT6000IDCB#TRMPBF | IC OPAMP GP 1 CIRCUIT 6DFN | U13 | CMP-09116-000039-1 | New From Design | Up to date | HYDRA_V4_NAV.PcbDoc | 1 | Analog Devices / Linear Technology | LT6000IDCB#TRMPBF | Volume Production | Newark | 51AK8950 | 2.96 | 2.96
 | LM73100RPWR | 2.7-V TO 23-V, 5.5-A IDEAL DIODE | U13_LS_0, U13_LS_1, U13_LS_2 | CMP-04910-000122-1 | New From Design | Up to date | HYDRA_V4_POWER.PcbDoc | 6 | Texas Instruments | LM73100RPWR | Volume Production | Digikey | 296-LM73100RPWRCT-ND | 1.49 | 8.94
 | ADS130B04QPWRQ1 | Automotive 16-bit, 32-kSPS, four-channel, simultaneous-sampling, delta-sigma ADC 20-TSSOP -40 to 125 | U14 | CMP-015-00014-2 | Draft | Up to date | HYDRA_V4_POWER.PcbDoc | 2 | Texas Instruments | ADS130B04QPWRQ1 | Unknown | Mouser | 595-ADS130B04QPWRQ1 | 6.55 | 13.1
 | TPS259830ONRGER | 2.7-V to 26-V, 2.7-mΩ 18-A integrated hot-swap eFuse with current monitor and blocking FET driver 24-VQFN -40 to 125 | U14 | CMP-019-00050-3 | Draft | Up to date | HYDRA_V4_NAV.PcbDoc | 1 | Texas Instruments | TPS259830ONRGER | Unknown | Mouser | 595-TPS259830ONRGER | 3.81 | 3.81
 | ABM8G-28.63636MHZ-18-D2Y-T | Crystal 28.63636MHz ±20ppm (Tol) ±30ppm (Stability) 18pF FUND 50Ω 4-Pin SMD T/R | Y1 | CMP-27762-014063-1 | New From Design | Up to date | HYDRA_V4_RECOVERY.PcbDoc | 1 | Abracon | ABM8G-28.63636MHZ-18-D2Y-T | Unknown | Mouser | 815-ABM8G-28.6-18D2Y | 0.57 | 0.57
 | ABM8G-25.000MHZ-18-D2Y-T | Crystal 25MHz ±20ppm (Tol) ±30ppm (Stability) 18pF FUND 60Ω 4-Pin SMD T/R | Y1, Y2 | CMP-2000-05733-3 | Released | Up to date | HYDRA_V4_POWER.PcbDoc, HYDRA_V4_LINK_V2.PcbDoc, HYDRA_V4_NAV.PcbDoc, HYDRA_V4_RECOVERY.PcbDoc | 6 | Abracon | ABM8G-25.000MHZ-18-D2Y-T | Unknown | Farnell | 2101339 | 0.38134 | 2.29
 | ECS-.327-12.5-1210-TR | CRYSTAL 32.7680KHZ 12.5PF SMD | Y2, Y3 | CMP-40224-000006-1 | New From Design | Up to date | HYDRA_V4_POWER.PcbDoc, HYDRA_V4_NAV.PcbDoc, HYDRA_V4_LINK_V2.PcbDoc, HYDRA_V4_RECOVERY.PcbDoc | 5 | ECS International | ECS-.327-12.5-1210-TR | Volume Production | Mouser | 520-.327-12.5-1210T | 1.31 | 6.55
