Serpopovici163/HYDRA_HARDWARE/PWR_CALCS.xlsx

Sheet: LM73100
3v3 | R1 | 470 | 470
 | R2 | 25.15050167 | 32.4
 | R3 | 264.0802676 | 270
 | Vin_UV | 3.065079365
 | Vin_OV | 3.432888889
 | R4 | 110
 | R5 | 68
 | V_PG | 3.141176471
 | V_IMON | 1.5
 | I_MAX | 3
 | R_IMON | 2747.252747
5v | R1 | 270 | 270 | R1 | 680 | 470
 | R2 | 6.923076923 | 10 | R2 | 17.43589744 | 10
 | R3 | 83.07692308 | 80.6 | R3 | 209.2307692 | 270
 | Vin_UV | 4.77615894 |  | Vin_UV | 3.214285714
 | Vin_OV | 5.368734491 |  | Vin_OV | 3.333333333
 | R4 | 68
 | R5 | 24
 | V_PG | 4.6
 | V_IMON | 1.5
 | I_MAX | 3
 | R_IMON | 2747.252747
VCC | R1 | 32.4 | 32.4
 | R2 | 1.819251337 | 3.9
 | R3 | 2.598930481 | 2.7
 | Vin_UV | 7.090909091
 | Vin_OV | 17.33333333
 | R4 | 680
 | R5 | 100
 | V_PG | 9.36
 | V_IMON | 1.5
 | I_MAX | 3
 | R_IMON | 2747.252747

Sheet: TPS1641
3v3 |  | 5v |  | vcc |  | ilim resistors |  | imon res
R1 | 540 | R1 | 480 | R1 | 920 | .25a | 39.36k | 199.2k
R2 | 430 | R2 | 200 | R2 | 91 | .5a | 19.68k | 99.8k
 |  |  |  |  |  | .75a | 13.12k | 66.6k
VOVPR | 1.53 | VOVPR | 1.53 | VOVPR | 1.53 | 1a | 9.84k | 49.95k
VOVPF | 1.4 | VOVPF | 1.4 | VOVPF | 1.4 | 1.5a | 6.56k | 33.31k
OVP_RISING | 3.451395349 | OVP_RISING | 5.202 | OVP_RISING | 16.99813187
OVP_FALLING | 3.158139535 | OVP_FALLING | 4.76 | OVP_FALLING | 15.55384615
