Serpopovici163/HYDRA_HARDWARE/0_MISC_CAD/2_SECOND_CERT_ATTEMPT/HYDRA_ASSY/2025_04_26_HYDRA_V4_NAV/HYDRA_V4_NAV.SLDASM

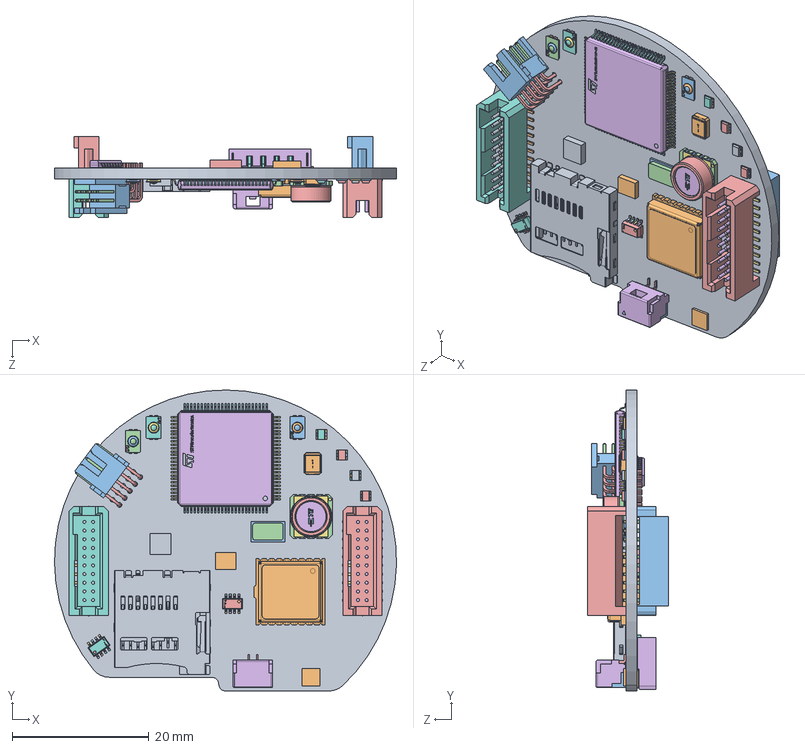
[picture p11: CAD file, 2025-09-30]
0_MISC_CAD/2_SECOND_CERT_ATTEMPT/HYDRA_ASSY/2025_04_26_HYDRA_V4_NAV/HYDRA_V4_NAV.SLDASM
50.0 x 44.0 x 11.8 mm
