Serpopovici163/HYDRA_HARDWARE/0_MISC_CAD/2_SECOND_CERT_ATTEMPT/HYDRA_ASSY/2025_04_26_HYDRA_V4_POWER/HYDRA_V4_POWER.SLDASM

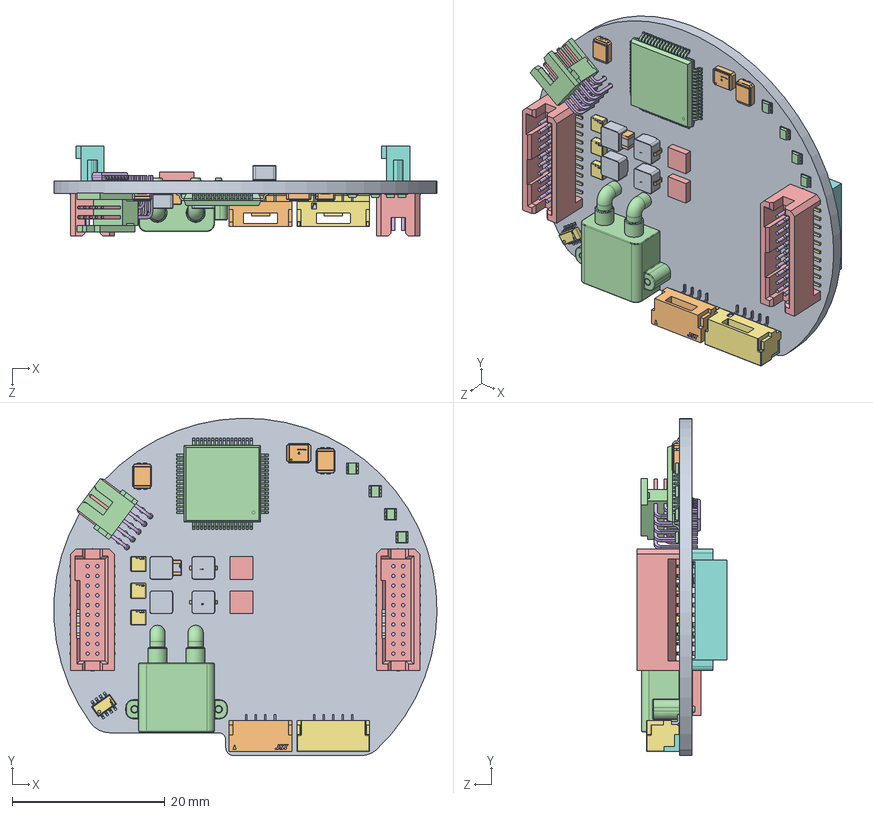
[picture p12: CAD file, 2025-09-30]
0_MISC_CAD/2_SECOND_CERT_ATTEMPT/HYDRA_ASSY/2025_04_26_HYDRA_V4_POWER/HYDRA_V4_POWER.SLDASM
50.1 x 44.1 x 11.8 mm
Pins
New Marking
JST Logo
SM05B-GHS-TB
JST Logo adjustable
Pads x 4
Dome x 4
Extruded_2
Texas Logo Yury x 3
Texas Logo Yury - Copy x 3
Termination
Marking
Logo
IC_BODY
IC_LEG x 4
circle
Texas Instruments
IC_LEG_MIR3 x 4
Extruded_4 x 2
terminals_3 x 2
button top x 2
logo_3 x 2
Pins_2 x 2
Logo_2 x 2
FTSH-105-01-F-D-RA-K_body
FTSH-105-01-F-D-RA-K_pins1
FTSH-105-01-F-D-RA-K_pins2
terminals_5 x 3
logo_5 x 3
side x 2
Murata_2
TFML-110-02-L-D-A_terminal x 2
TFML-110-02-L-D-L_pins x 2
TFML-110-02-L-D-S-2_pins x 2
SFML-110-02-L-D-A_terminal x 2
C-10-02-D-L_pins x 2
