Serpopovici163/HYDRA_HARDWARE/0_MISC_CAD/L1_L2_INTEGRATION/ROCKET_MAIN_PARACHUTE_VOLUME.SLDPRT

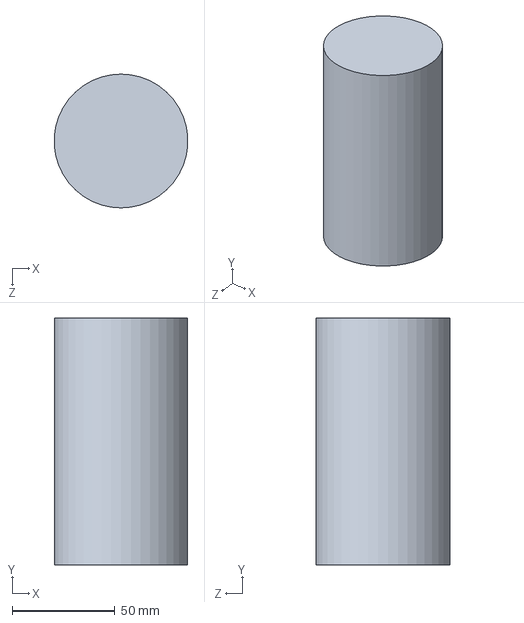
[picture p13: CAD file, 2025-04-27]
0_MISC_CAD/L1_L2_INTEGRATION/ROCKET_MAIN_PARACHUTE_VOLUME.SLDPRT
64.8 x 120.0 x 65.0 mm
