Serpopovici163/HYDRA_HARDWARE/(list of files, cad)

Other CAD files:
0_MISC_CAD/HYDRA_ASSY/2025_04_26_HYDRA_V4_POWER/Q9.SLDASM
0_MISC_CAD/2_SECOND_CERT_ATTEMPT/HYDRA_ASSY/2025_04_26_HYDRA_V4_POWER/R17.SLDASM
0_MISC_CAD/HYDRA_ASSY/2025_04_26_HYDRA_V4_POWER/Cap_Taiyo_Yuden_QVS105CG0R9BVHF_eec.SLDASM
0_MISC_CAD/2_SECOND_CERT_ATTEMPT/HYDRA_ASSY/2025_04_26_HYDRA_V4_POWER/R89.SLDASM
0_MISC_CAD/HYDRA_ASSY/2025_04_26_HYDRA_V4_POWER/C27.SLDASM
0_MISC_CAD/2_SECOND_CERT_ATTEMPT/HYDRA_ASSY/2025_04_26_HYDRA_V4_POWER/R100_LS_2.SLDASM
0_MISC_CAD/HYDRA_ASSY/2025_04_26_HYDRA_V4_POWER/Res_Vishay_WSLP1206R0100FEA_eec.SLDASM
0_MISC_CAD/2_SECOND_CERT_ATTEMPT/HYDRA_ASSY/2025_04_26_HYDRA_V4_POWER/Q11.SLDASM
0_MISC_CAD/HYDRA_ASSY/2025_04_26_HYDRA_V4_POWER/C37.SLDASM
0_MISC_CAD/HYDRA_ASSY/2025_04_26_HYDRA_V4_POWER/R87.SLDASM
0_MISC_CAD/HYDRA_ASSY/2025_04_26_HYDRA_V4_POWER/D8.SLDASM
0_MISC_CAD/2_SECOND_CERT_ATTEMPT/HYDRA_ASSY/2025_04_26_HYDRA_V4_POWER/C9.SLDASM
0_MISC_CAD/HYDRA_ASSY/2025_04_26_HYDRA_V4_POWER/C20.SLDASM
0_MISC_CAD/2_SECOND_CERT_ATTEMPT/HYDRA_ASSY/2025_04_26_HYDRA_V4_POWER/Terminal_5.SLDASM
0_MISC_CAD/HYDRA_ASSY/2025_04_26_HYDRA_V4_POWER/Q12.SLDASM
0_MISC_CAD/HYDRA_ASSY/2025_04_26_HYDRA_V4_POWER/Terminal_4.SLDASM
0_MISC_CAD/HYDRA_ASSY/2025_04_26_HYDRA_V4_POWER/C39.SLDASM
0_MISC_CAD/HYDRA_ASSY/2025_04_26_HYDRA_V4_POWER/C25.SLDASM
0_MISC_CAD/2_SECOND_CERT_ATTEMPT/HYDRA_ASSY/2025_04_26_HYDRA_V4_POWER/U13_LS_2.SLDASM
0_MISC_CAD/HYDRA_ASSY/2025_04_26_HYDRA_V4_POWER/C42_LS_2.SLDASM
0_MISC_CAD/HYDRA_ASSY/2025_04_26_HYDRA_V4_POWER/C7.SLDASM
0_MISC_CAD/2_SECOND_CERT_ATTEMPT/HYDRA_ASSY/2025_04_26_HYDRA_V4_POWER/R60.SLDASM
0_MISC_CAD/HYDRA_ASSY/2025_04_26_HYDRA_V4_POWER/SW3.SLDASM
0_MISC_CAD/2_SECOND_CERT_ATTEMPT/HYDRA_ASSY/2025_04_26_HYDRA_V4_POWER/R102_LS_1.SLDASM
0_MISC_CAD/2_SECOND_CERT_ATTEMPT/HYDRA_ASSY/2025_04_26_HYDRA_V4_POWER/C30.SLDASM
0_MISC_CAD/HYDRA_ASSY/2025_04_26_HYDRA_V4_POWER/Q8.SLDASM
0_MISC_CAD/HYDRA_ASSY/2025_04_26_HYDRA_V4_POWER/C49.SLDASM
0_MISC_CAD/HYDRA_ASSY/2025_04_26_HYDRA_V4_POWER/C12.SLDASM
0_MISC_CAD/2_SECOND_CERT_ATTEMPT/HYDRA_ASSY/2025_04_26_HYDRA_V4_POWER/R101_LS_0.SLDASM
0_MISC_CAD/HYDRA_ASSY/2025_04_26_HYDRA_V4_POWER/Q6.SLDASM
0_MISC_CAD/2_SECOND_CERT_ATTEMPT/HYDRA_ASSY/2025_04_26_HYDRA_V4_POWER/R2.SLDASM
0_MISC_CAD/2_SECOND_CERT_ATTEMPT/HYDRA_ASSY/2025_04_26_HYDRA_V4_POWER/IC_Texas_Instruments_LM74700QDBVRQ1_eec.SLDASM
0_MISC_CAD/2_SECOND_CERT_ATTEMPT/HYDRA_ASSY/2025_04_26_HYDRA_V4_POWER/C7.SLDASM
0_MISC_CAD/2_SECOND_CERT_ATTEMPT/HYDRA_ASSY/2025_04_26_HYDRA_V4_POWER/R74.SLDASM
0_MISC_CAD/2_SECOND_CERT_ATTEMPT/HYDRA_ASSY/2025_04_26_HYDRA_V4_POWER/Y2.SLDASM
0_MISC_CAD/HYDRA_ASSY/2025_04_26_HYDRA_V4_POWER/R61.SLDASM
0_MISC_CAD/2_SECOND_CERT_ATTEMPT/HYDRA_ASSY/2025_04_26_HYDRA_V4_POWER/C28.SLDASM
0_MISC_CAD/HYDRA_ASSY/2025_04_26_HYDRA_V4_POWER/R89.SLDASM
0_MISC_CAD/2_SECOND_CERT_ATTEMPT/HYDRA_ASSY/2025_04_26_HYDRA_V4_POWER/Trans_Toshiba_SSM6N7002KFU_LF_eec.SLDASM
0_MISC_CAD/2_SECOND_CERT_ATTEMPT/HYDRA_ASSY/2025_04_26_HYDRA_V4_POWER/C41.SLDASM
0_MISC_CAD/HYDRA_ASSY/2025_04_26_HYDRA_V4_POWER/R64.SLDASM
0_MISC_CAD/2_SECOND_CERT_ATTEMPT/HYDRA_ASSY/2025_04_26_HYDRA_V4_POWER/R42.SLDASM
0_MISC_CAD/HYDRA_ASSY/2025_04_26_HYDRA_V4_POWER/R56.SLDASM
0_MISC_CAD/HYDRA_ASSY/2025_04_26_HYDRA_V4_POWER/D7.SLDASM
0_MISC_CAD/HYDRA_ASSY/2025_04_26_HYDRA_V4_POWER/Q15.SLDASM
0_MISC_CAD/2_SECOND_CERT_ATTEMPT/HYDRA_ASSY/2025_04_26_HYDRA_V4_POWER/R97_LS_1.SLDASM
0_MISC_CAD/HYDRA_ASSY/2025_04_26_HYDRA_V4_POWER/D10.SLDASM
0_MISC_CAD/2_SECOND_CERT_ATTEMPT/HYDRA_ASSY/2025_04_26_HYDRA_V4_POWER/Terminal_4.SLDASM
0_MISC_CAD/HYDRA_ASSY/2025_04_26_HYDRA_V4_POWER/R88.SLDASM
0_MISC_CAD/2_SECOND_CERT_ATTEMPT/HYDRA_ASSY/2025_04_26_HYDRA_V4_POWER/F2.SLDASM
0_MISC_CAD/HYDRA_ASSY/2025_04_26_HYDRA_V4_POWER/Body_2.SLDASM
0_MISC_CAD/2_SECOND_CERT_ATTEMPT/HYDRA_ASSY/2025_04_26_HYDRA_V4_POWER/R61.SLDASM
0_MISC_CAD/HYDRA_ASSY/2025_04_26_HYDRA_V4_POWER/Crys_Abracon_ABM8G-12_288MHZ-18-D2Y-T3_eec.SLDASM
0_MISC_CAD/HYDRA_ASSY/2025_04_26_HYDRA_V4_POWER/R4.SLDASM
0_MISC_CAD/2_SECOND_CERT_ATTEMPT/HYDRA_ASSY/2025_04_26_HYDRA_V4_POWER/J8.SLDASM
0_MISC_CAD/HYDRA_ASSY/2025_04_26_HYDRA_V4_POWER/Fuse_Bel_Fuse_0ZCK0010FF2G_eec.SLDASM
0_MISC_CAD/2_SECOND_CERT_ATTEMPT/HYDRA_ASSY/2025_04_26_HYDRA_V4_POWER/D9.SLDASM
0_MISC_CAD/HYDRA_ASSY/2025_04_26_HYDRA_V4_POWER/R13.SLDASM
0_MISC_CAD/HYDRA_ASSY/2025_04_26_HYDRA_V4_POWER/C24.SLDASM
0_MISC_CAD/2_SECOND_CERT_ATTEMPT/HYDRA_ASSY/2025_04_26_HYDRA_V4_POWER/R98_LS_0.SLDASM
0_MISC_CAD/HYDRA_ASSY/2025_04_26_HYDRA_V4_POWER/Q3.SLDASM
0_MISC_CAD/HYDRA_ASSY/2025_04_26_HYDRA_V4_POWER/Conn_JST_SM05B-GHS-TB_LF_SN_eec.SLDASM
0_MISC_CAD/2_SECOND_CERT_ATTEMPT/HYDRA_ASSY/2025_04_26_HYDRA_V4_POWER/C42_LS_2.SLDASM
0_MISC_CAD/HYDRA_ASSY/2025_04_26_HYDRA_V4_POWER/Terminal.SLDASM
0_MISC_CAD/2_SECOND_CERT_ATTEMPT/HYDRA_ASSY/2025_04_26_HYDRA_V4_POWER/C1.SLDASM
0_MISC_CAD/HYDRA_ASSY/2025_04_26_HYDRA_V4_POWER/R98_LS_0.SLDASM
0_MISC_CAD/2_SECOND_CERT_ATTEMPT/HYDRA_ASSY/2025_04_26_HYDRA_V4_POWER/R8.SLDASM
0_MISC_CAD/HYDRA_ASSY/2025_04_26_HYDRA_V4_POWER/C9.SLDASM
0_MISC_CAD/HYDRA_ASSY/2025_04_26_HYDRA_V4_POWER/R62.SLDASM
0_MISC_CAD/2_SECOND_CERT_ATTEMPT/HYDRA_ASSY/2025_04_26_HYDRA_V4_POWER/Board.SLDASM
0_MISC_CAD/HYDRA_ASSY/2025_04_26_HYDRA_V4_POWER/R35.SLDASM
0_MISC_CAD/2_SECOND_CERT_ATTEMPT/HYDRA_ASSY/2025_04_26_HYDRA_V4_POWER/R76.SLDASM
0_MISC_CAD/HYDRA_ASSY/2025_04_26_HYDRA_V4_POWER/F4.SLDASM
0_MISC_CAD/2_SECOND_CERT_ATTEMPT/HYDRA_ASSY/2025_04_26_HYDRA_V4_POWER/C31.SLDASM
0_MISC_CAD/HYDRA_ASSY/2025_04_26_HYDRA_V4_POWER/R52.SLDASM
0_MISC_CAD/2_SECOND_CERT_ATTEMPT/HYDRA_ASSY/2025_04_26_HYDRA_V4_POWER/R97_LS_2.SLDASM
0_MISC_CAD/HYDRA_ASSY/2025_04_26_HYDRA_V4_POWER/C50.SLDASM
0_MISC_CAD/2_SECOND_CERT_ATTEMPT/HYDRA_ASSY/2025_04_26_HYDRA_V4_POWER/R9.SLDASM
0_MISC_CAD/HYDRA_ASSY/2025_04_26_HYDRA_V4_POWER/R29.SLDASM
0_MISC_CAD/HYDRA_ASSY/2025_04_26_HYDRA_V4_POWER/R97_LS_1.SLDASM
0_MISC_CAD/2_SECOND_CERT_ATTEMPT/HYDRA_ASSY/2025_04_26_HYDRA_V4_POWER/Q12.SLDASM
0_MISC_CAD/HYDRA_ASSY/2025_04_26_HYDRA_V4_POWER/Q16.SLDASM
0_MISC_CAD/2_SECOND_CERT_ATTEMPT/HYDRA_ASSY/2025_04_26_HYDRA_V4_POWER/R33.SLDASM
0_MISC_CAD/2_SECOND_CERT_ATTEMPT/HYDRA_ASSY/2025_04_26_HYDRA_V4_POWER/R58.SLDASM
0_MISC_CAD/HYDRA_ASSY/2025_04_26_HYDRA_V4_POWER/R34.SLDASM
0_MISC_CAD/HYDRA_ASSY/2025_04_26_HYDRA_V4_POWER/R39.SLDASM
0_MISC_CAD/2_SECOND_CERT_ATTEMPT/HYDRA_ASSY/2025_04_26_HYDRA_V4_POWER/C42_LS_0.SLDASM
0_MISC_CAD/HYDRA_ASSY/2025_04_26_HYDRA_V4_POWER/C53.SLDASM
0_MISC_CAD/2_SECOND_CERT_ATTEMPT/HYDRA_ASSY/2025_04_26_HYDRA_V4_POWER/R28.SLDASM
0_MISC_CAD/HYDRA_ASSY/2025_04_26_HYDRA_V4_POWER/R2.SLDASM
0_MISC_CAD/HYDRA_ASSY/2025_04_26_HYDRA_V4_POWER/R28.SLDASM
0_MISC_CAD/HYDRA_ASSY/2025_04_26_HYDRA_V4_POWER/R100_LS_1.SLDASM
0_MISC_CAD/HYDRA_ASSY/2025_04_26_HYDRA_V4_POWER/R70.SLDASM
0_MISC_CAD/2_SECOND_CERT_ATTEMPT/HYDRA_ASSY/2025_04_26_HYDRA_V4_POWER/R4.SLDASM
0_MISC_CAD/2_SECOND_CERT_ATTEMPT/HYDRA_ASSY/2025_04_26_HYDRA_V4_POWER/R86.SLDASM
0_MISC_CAD/2_SECOND_CERT_ATTEMPT/HYDRA_ASSY/2025_04_26_HYDRA_V4_POWER/IC_Texas_Instruments_TLV3502AIDCNT_eec.SLDASM
0_MISC_CAD/HYDRA_ASSY/2025_04_26_HYDRA_V4_POWER/Q1.SLDASM
0_MISC_CAD/HYDRA_ASSY/2025_04_26_HYDRA_V4_POWER/R54.SLDASM
0_MISC_CAD/2_SECOND_CERT_ATTEMPT/HYDRA_ASSY/2025_04_26_HYDRA_V4_POWER/Q9.SLDASM
0_MISC_CAD/HYDRA_ASSY/2025_04_26_HYDRA_V4_POWER/C33.SLDASM
0_MISC_CAD/2_SECOND_CERT_ATTEMPT/HYDRA_ASSY/2025_04_26_HYDRA_V4_POWER/Q4.SLDASM
0_MISC_CAD/2_SECOND_CERT_ATTEMPT/HYDRA_ASSY/2025_04_26_HYDRA_V4_POWER/Crys_ECS_International_ECS-_327-12_5-1210-TR_eec.SLDASM
0_MISC_CAD/HYDRA_ASSY/2025_04_26_HYDRA_V4_POWER/R25.SLDASM
0_MISC_CAD/2_SECOND_CERT_ATTEMPT/HYDRA_ASSY/2025_04_26_HYDRA_V4_POWER/R43.SLDASM
0_MISC_CAD/HYDRA_ASSY/2025_04_26_HYDRA_V4_POWER/R36.SLDASM
0_MISC_CAD/2_SECOND_CERT_ATTEMPT/HYDRA_ASSY/2025_04_26_HYDRA_V4_POWER/Ind_Vishay_IHLP1212BZER2R2M11_eec.SLDASM
0_MISC_CAD/HYDRA_ASSY/2025_04_26_HYDRA_V4_POWER/R10.SLDASM
0_MISC_CAD/HYDRA_ASSY/2025_04_26_HYDRA_V4_POWER/C3.SLDASM
0_MISC_CAD/HYDRA_ASSY/2025_04_26_HYDRA_V4_POWER/R72.SLDASM
0_MISC_CAD/2_SECOND_CERT_ATTEMPT/HYDRA_ASSY/2025_04_26_HYDRA_V4_POWER/R21.SLDASM
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
