Serpopovici163/HYDRA_HARDWARE/(list of files, drawings)

Other design files:
HYDRA_V2.1_NAV/HYDRA_V2.1_NAV.PrjPcb
HYDRA_V2.1_NAV/HYDRA_V2.1_NAV.SchDoc
HYDRA_V2.1_NAV/OC_PROT.SchDoc
HYDRA_V2.1_NAV/SAME51_PINOUT.SchDoc
HYDRA_V2.1_NAV/SBG.SchDoc
HYDRA_V2.1_NAV/SD.SchDoc
HYDRA_V2.1_POWER/3V3_REG.SchDoc
HYDRA_V2.1_POWER/5V_REG.SchDoc
HYDRA_V2.1_POWER/HYDRA_V2.1_POWER.PrjPcb
HYDRA_V2.1_POWER/HYDRA_V2.1_POWER.SchDoc
HYDRA_V2.1_POWER/OC_PROT.SchDoc
HYDRA_V2.1_POWER/PWR_PROT.SchDoc
HYDRA_V2.1_POWER/SAME51_PINOUT.SchDoc
HYDRA_V3_BEACON/CAN_FD_INTERFACE.SchDoc
HYDRA_V3_BEACON/GPS.SchDoc
HYDRA_V3_BEACON/HYDRA_V3_BEACON.PrjPcb
HYDRA_V3_BEACON/HYDRA_V3_BEACON.SchDoc
HYDRA_V3_BEACON/OC_PROT.SchDoc
HYDRA_V3_BEACON/PWR_MGMT.SchDoc
HYDRA_V3_BEACON/STM32L0_PINOUT.SchDoc
HYDRA_V3_BEACON/SX1278_RADIO.SchDoc
HYDRA_V3_CAMERA/CAMERA_INTERFACE.SchDoc
HYDRA_V3_CAMERA/HYDRA_V3_CAMERA.PrjPcb
HYDRA_V3_CAMERA/HYDRA_V3_CAMERA.SchDoc
HYDRA_V3_CAMERA/OC_PROT.SchDoc
HYDRA_V3_CAMERA/SD.SchDoc
HYDRA_V3_CAMERA/STM32H733_PINOUT.SchDoc
HYDRA_V3_LINK/HYDRA_V3_LINK.PrjPcb
HYDRA_V3_LINK/HYDRA_V3_LINK.SchDoc
HYDRA_V3_LINK/INTERNAL_REGULATORS.SchDoc
HYDRA_V3_LINK/OC_PROT.SchDoc
HYDRA_V3_LINK/SAME51_PINOUT.SchDoc
HYDRA_V3_LINK/SD.SchDoc
HYDRA_V3_NAV_CRIPPLED/HYDRA_V3_NAV_CRIPPLED.PrjPcb
HYDRA_V3_NAV_CRIPPLED/HYDRA_V3_NAV_CRIPPLED.SchDoc
HYDRA_V3_NAV_CRIPPLED/OC_PROT.SchDoc
HYDRA_V3_NAV_CRIPPLED/SBG.SchDoc
HYDRA_V3_NAV_CRIPPLED/SD.SchDoc
HYDRA_V3_NAV_CRIPPLED/STM32H733_PINOUT.SchDoc
HYDRA_V3_POWER/HYDRA_V3_POWER.PcbDoc
HYDRA_V3_RECOVERY/HYDRA_V3_RECOVERY.PrjPcb
HYDRA_V3_RECOVERY_OLD/EJECTION_CIRCUIT.SchDoc
HYDRA_V3_RECOVERY_OLD/HYDRA_V3_RECOVERY.PrjPcb
HYDRA_V3_RECOVERY_OLD/HYDRA_V3_RECOVERY.SchDoc
HYDRA_V3_RECOVERY_OLD/IMU.SchDoc
HYDRA_V3_RECOVERY_OLD/OC_PROT.SchDoc
HYDRA_V3_RECOVERY_OLD/SAFETY_SWITCH.SchDoc
HYDRA_V3_RECOVERY_OLD/SAME51_PINOUT.SchDoc
HYDRA_V3_RECOVERY_OLD/SENSOR_BANK.SchDoc
HYDRA_V3_SAME51_TEMPLATE/HYDRA_V3_SAME51_TEMPLATE.PrjPcb
HYDRA_V3_SAME51_TEMPLATE/HYDRA_V3_TEMPLATE.PcbDoc
HYDRA_V3_SAME51_TEMPLATE/HYDRA_V3_TEMPLATE.SchDoc
HYDRA_V3_SAME51_TEMPLATE/HYDRA_V3_TEMPLATE_MCU_UNDER.PcbDoc
HYDRA_V4_ACTUATOR/ACT_REG.SchDoc
HYDRA_V4_ACTUATOR/HYDRA_V4_ACTUATOR.PrjPcb
HYDRA_V4_ACTUATOR/HYDRA_V4_ACTUATOR.SchDoc
HYDRA_V4_ACTUATOR/INT_REG.SchDoc
HYDRA_V4_ACTUATOR/PWR_MGMT.SchDoc
HYDRA_V4_ACTUATOR/STM32G473CET6_PINOUT.SchDoc
HYDRA_V4_LINK/BATT_MGMT.SchDoc
HYDRA_V4_LINK/ETHERNET.SchDoc
HYDRA_V4_LINK/HYDRA_V4_LINK.PcbDoc
HYDRA_V4_LINK/HYDRA_V4_LINK.PrjPcb
HYDRA_V4_LINK/HYDRA_V4_LINK.SchDoc
HYDRA_V4_LINK/OC_PROT.SchDoc
HYDRA_V4_LINK/RADIO.SchDoc
HYDRA_V4_LINK/RFD_PWR_MGMT.SchDoc
HYDRA_V4_LINK/SD.SchDoc
HYDRA_V4_LINK/STM32G473CET6_PINOUT.SchDoc
HYDRA_V4_LINK/TCAN330_PINOUT.SchDoc
HYDRA_V4_LINK/TCAN1146_PINOUT.SchDoc
HYDRA_V4_NAV/ACTUATOR_PWR_PROT.SchDoc
HYDRA_V4_NAV/GPS.SchDoc
HYDRA_V4_NAV/HYDRA_V4_NAV.PrjPcb
HYDRA_V4_NAV/HYDRA_V4_NAV.SchDoc
HYDRA_V4_NAV/IMU.SchDoc
HYDRA_V4_NAV/OC_PROT.SchDoc
HYDRA_V4_NAV/OC_PROT_with_5V.SchDoc
HYDRA_V4_NAV/SD.SchDoc
HYDRA_V4_NAV/STM32H730_PINOUT.SchDoc
HYDRA_V4_NAV/TCAN330_PINOUT.SchDoc
HYDRA_V4_NAV/TCAN1146_PINOUT.SchDoc
HYDRA_V4_POWER/CELL_SENSE.SchDoc
HYDRA_V4_POWER/HYDRA_REGULATORS.SchDoc
HYDRA_V4_POWER/HYDRA_V4_POWER.PrjPcb
HYDRA_V4_POWER/HYDRA_V4_POWER.SchDoc
HYDRA_V4_POWER/INT_REG.SchDoc
HYDRA_V4_POWER/LM7310.SchDoc
HYDRA_V4_POWER/MOSFET_JUNCTION.SchDoc
HYDRA_V4_POWER/PG_MUX.SchDoc
HYDRA_V4_POWER/PWR_PROT.SchDoc
HYDRA_V4_POWER/RP_AND_SAFETYSW.SchDoc
HYDRA_V4_POWER/STM32G473RET6_PINOUT.SchDoc
HYDRA_V4_POWER/TCAN330_PINOUT.SchDoc
HYDRA_V4_POWER/TCAN1146_PINOUT.SchDoc
HYDRA_V4_RECOVERY/CAMERA_INTERFACE.SchDoc
HYDRA_V4_RECOVERY/EJECTION_CIRCUIT.SchDoc
HYDRA_V4_RECOVERY/HYDRA_V4_RECOVERY.PrjPcb
HYDRA_V4_RECOVERY/HYDRA_V4_RECOVERY.SchDoc
HYDRA_V4_RECOVERY/OC_PROT.SchDoc
HYDRA_V4_RECOVERY/SAFETY_SWITCH.SchDoc
HYDRA_V4_RECOVERY/SD.SchDoc
HYDRA_V4_RECOVERY/SENSOR_BANK.SchDoc
HYDRA_V4_RECOVERY/STM32H730_PINOUT.SchDoc
HYDRA_V4_RECOVERY/TCAN330_PINOUT.SchDoc
HYDRA_V4_RECOVERY/TCAN1146_PINOUT.SchDoc
