Serpopovici163/HYDRA_HARDWARE/HYDRA_V4_LINK/0_SOFTWARE/0_SOFTWARE.ioc

Mcu.UserName=STM32G473RETx
PA0.GPIO_Label=VBAT_V_SENSE
PA0.Signal=ADC1_IN1
PA1.GPIO_Label=VBAT_I_SENSE
PA1.Signal=ADC1_IN2
PA10.GPIO_Label=nBAT_BST_FLT
PA10.Signal=GPIO_Input
PA12.GPIO_Label=nUPS_ACTIVE
PA12.Signal=GPXTI12
PA13.Signal=SYS_JTMS-SWDIO
PA14.Signal=SYS_JTCK-SWCLK
PA15.GPIO_Label=AUX_RAD_PWR_EN
PA15.Signal=GPIO_Output
PA2.GPIO_Label=PYRO_PWR_I_SENSE
PA2.Signal=ADC1_IN3
PA3.GPIO_Label=PYRO_PWR_V_SENSE
PA3.Signal=ADC1_IN4
PA4.GPIO_Label=nETH_CS
PA4.Signal=GPIO_Output
PA5.Signal=SPI1_SCK
PA6.Signal=SPI1_MISO
PA7.Signal=SPI1_MOSI
PA8.GPIO_Label=nON_PYRO_PWR
PA8.Signal=GPXTI8
PA9.GPIO_Label=INT_3V3_V_SENSE
PA9.Signal=ADC5_IN2
PB0.GPIO_Label=ETH_EN
PB0.Signal=GPIO_Output
PB1.GPIO_Label=AUX_RAD_V_SENSE
PB1.Signal=ADC1_IN12
PB10.GPIO_Label=nAUX_RAD_REG_FLT
PB10.Signal=GPIO_Input
PB11.GPIO_Label=nSD_CD
PB11.Signal=GPXTI11
PB12.Signal=SPI2_NSS
PB13.Signal=SPI2_SCK
PB14.Signal=SPI2_MISO
PB15.Signal=SPI2_MOSI
PB2.GPIO_Label=VCC_V_SENSE
PB2.Signal=ADC2_IN12
PB3.Signal=SYS_JTDO-SWO
PB4.GPIO_Label=nTCAN1146_CS
PB4.Signal=GPIO_Output
PB5.Signal=FDCAN2_RX
PB6.Signal=FDCAN2_TX
PB7.GPIO_Label=nLORA_EN
PB7.Signal=GPIO_Output
PB8-BOOT0.Signal=FDCAN1_RX
PB9.Signal=FDCAN1_TX
PC0.GPIO_Label=HYDRA_5V_I_SENSE
PC0.Signal=ADC1_IN6
PC1.GPIO_Label=HYDRA_5V_V_SENSE
PC1.Signal=ADC1_IN7
PC10.GPIO_Label=AUX_RAD_REG_INH
PC10.Signal=GPIO_Output
PC11.GPIO_Label=nLORA_RST
PC11.Signal=GPIO_Output
PC12.Signal=UART5_TX
PC13.GPIO_Label=nLORA_CS
PC13.Signal=GPIO_Output
PC14-OSC32_IN.Signal=RCC_OSC32_IN
PC15-OSC32_OUT.Signal=RCC_OSC32_OUT
PC2.GPIO_Label=HYDRA_3V3_I_SENSE
PC2.Signal=ADC1_IN8
PC3.GPIO_Label=HYDRA_3V3_V_SENSE
PC3.Signal=ADC1_IN9
PC4.GPIO_Label=nETH_RST
PC4.Signal=GPIO_Output
PC5.GPIO_Label=nETH_INT
PC5.Signal=GPXTI5
PC6.GPIO_Label=nBATT_EN
PC6.Signal=GPIO_Output
PC7.GPIO_Label=nBAT_CHRG_CHG
PC7.Signal=GPIO_Input
PC8.GPIO_Label=nFST_CHG_EN
PC8.Signal=GPIO_Output
PC9.GPIO_Label=nBAT_CHRG_PG
PC9.Signal=GPIO_Input
PD2.Signal=UART5_RX
PF0-OSC_IN.Signal=RCC_OSC_IN
PF1-OSC_OUT.Signal=RCC_OSC_OUT
