Serpopovici163/HYDRA_HARDWARE/(commit log)

2024-07-27 HYDRA_V3_POWER schematic draft complete aside from hydra regulator oring
    [3V3REG.SchDoc, CELL_SENSE.SchDoc, HYDRA_REGULATORS.SchDoc, HYDRA_V3_POWER.PcbDoc, HYDRA_V3_POWER.PrjPcb, HYDRA_V3_POWER.SchDoc, INT_REG.SchDoc, MOSFET_JUNCTION.SchDoc]
2024-07-27 commiting before updating MCU name
    [HYDRA_V3_POWER.SchDoc, SAME51_PINOUT.SchDoc]
2024-07-27 altium wants to commit rn
    [HYDRA_V3_POWER.PrjPcb, HYDRA_V3_POWER.SchDoc, SAME51_PINOUT.SchDoc, STM32L051R8T6_PINOUT.SchDoc]
2024-07-27 last commit tn, need to add supply oring, integrate MCU, revise schematics, and do layout for HYDRA_V3_POWER
    [STM32L051R8T6_PINOUT.SchDoc]
2024-07-27 started adding MCU to power board
    [STM32L051R8T6_PINOUT.SchDoc]
2024-07-29 not sure what happened but something happened
    [STM32L051R8T6_PINOUT.SchDoc]
2024-08-12 started work on NAV
    [GPS.SchDoc, HYDRA_V3_NAV.PrjPcb, HYDRA_V3_NAV.SchDoc, IIM-20670.SchDoc, OC_PROT.SchDoc, SAME51_PINOUT.SchDoc, SD.SchDoc, STM32H730_PINOUT.SchDoc]
2024-08-12 nearly done NAV schematics, still need to correct and then layout
    [ACTUATOR_PWR_PROT.SchDoc, GPS.SchDoc, HYDRA_V3_NAV.PrjPcb, HYDRA_V3_NAV.SchDoc, IIM-20670.SchDoc, IMU.SchDoc, OC_PROT.SchDoc, SD.SchDoc]
2024-08-18 started nav layout
    [ACTUATOR_PWR_PROT.SchDoc, GPS.SchDoc, HYDRA_V3_NAV.PrjPcb, HYDRA_V3_NAV.SchDoc, IMU.SchDoc, OC_PROT.SchDoc, SAME51_PINOUT.SchDoc, SD.SchDoc]
2024-08-22 started NAV layout but I lack braincells
    [ACTUATOR_PWR_PROT.SchDoc, HYDRA_V3_NAV.SchDoc, IMU.SchDoc, OC_PROT.SchDoc, STM32H730_PINOUT.SchDoc]
2024-08-30 worked a tiny bit on nav
    [OC_PROT.SchDoc, STM32H730_PINOUT.SchDoc]
2024-09-02 backup while working on nav
    [ACTUATOR_PWR_PROT.SchDoc, GPS.SchDoc, OC_PROT.SchDoc, STM32H730_PINOUT.SchDoc]
2024-09-04 almost done routing first version of V3 nav
    [IMU.SchDoc, STM32H730_PINOUT.SchDoc]
2024-09-05 done first iteration of nav component layout, not routed and definitely gonna have to clean up layout
    [ACTUATOR_PWR_PROT.SchDoc, HYDRA_V3_NAV.SchDoc, OC_PROT.SchDoc, STM32H730_PINOUT.SchDoc]
2024-09-22 finished NAV routing but schematics not done, no adc pins wired to MCU. also need to review schematics
    [ACTUATOR_PWR_PROT.SchDoc, HYDRA_V3_NAV.PrjPcb, HYDRA_V3_NAV.SchDoc, IMU.SchDoc, OC_PROT.SchDoc, OC_PROT_with_5V.SchDoc, STM32H730_PINOUT.SchDoc]
2024-10-03 started working on V3 recovery schematics
    [HYDRA_V3_RECOVERY.PrjPcb, HYDRA_V3_RECOVERY.SchDoc, SENSORS.SchDoc, STM32G473CET6_PINOUT.SchDoc]
2024-10-04 started working on power board schematics, just missing load sharing and better current sense
    [CELL_SENSE.SchDoc, EJECTION_CIRCUIT.SchDoc, HYDRA_REGULATORS.SchDoc, HYDRA_V3_POWER.PrjPcb, HYDRA_V3_POWER.SchDoc, HYDRA_V3_RECOVERY.SchDoc, INT_REG.SchDoc, MOSFET_JUNCTION.SchDoc]
2024-10-04 power board may actually fit
    [HYDRA_V3_POWER.SchDoc, INT_REG.SchDoc, MOSFET_JUNCTION.SchDoc, PWR_PROT.SchDoc, RP_AND_SAFETYSW.SchDoc]
2024-10-05 started recovery layout
    [EJECTION_CIRCUIT.SchDoc, HYDRA_V3_RECOVERY.PrjPcb, HYDRA_V3_RECOVERY.SchDoc, OC_PROT.SchDoc, SAFETY_SWITCH.SchDoc, SENSOR_BANK.SchDoc, STM32G473CET6_PINOUT.SchDoc]
2024-10-09 pushing to add documentation
    [HYDRA_V3_POWER.SchDoc, HYDRA_V3_RECOVERY.SchDoc, STM32G473CET6_PINOUT.SchDoc]
2024-10-11 added v2.1 nav and power
    [3V3_REG.SchDoc, 5V_REG.SchDoc, HYDRA_V2.1_NAV.PrjPcb, HYDRA_V2.1_NAV.SchDoc, HYDRA_V2.1_POWER.PrjPcb, HYDRA_V2.1_POWER.SchDoc, OC_PROT.SchDoc, PWR_PROT.SchDoc]
2024-10-17 continued the piss poor layout of V3 recovery board, will fix for V4 but need something to test the new STM32G473 chip schematic
    [HYDRA_V3_POWER.SchDoc, HYDRA_V3_RECOVERY.SchDoc, STM32G473CET6_PINOUT.SchDoc]
2024-10-17 deleted history file from power
2024-10-19 started recovery v2 layout
    [HYDRA_V3_RECOVERY.SchDoc, OC_PROT.SchDoc]
2024-10-20 still didn't fully push
    [HYDRA_V3_RECOVERY.PrjPcb]
2024-10-20 finished v3 recovery layout
    [HYDRA_V3_RECOVERY.PrjPcb, HYDRA_V3_RECOVERY.SchDoc, OC_PROT.SchDoc, STM32G473CET6_PINOUT.SchDoc]
2024-10-22 pushing just to be safe, not much work done
    [HYDRA_REGULATORS.SchDoc]
2024-12-14 doing final review of NAV prior to ordering
    [ACTUATOR_PWR_PROT.SchDoc, GPS.SchDoc, HYDRA_V3_NAV.SchDoc, IMU.SchDoc, OC_PROT.SchDoc, SD.SchDoc]
2024-12-17 redoing mosfet junction of v3 power
    [HYDRA_V3_POWER.SchDoc, MOSFET_JUNCTION.SchDoc, PWR_PROT.SchDoc, RP_AND_SAFETYSW.SchDoc]
2024-12-21 I think I've figured out power sharing for V3_PWR but I'll rename V3_PWR to V4_PWR
    [CELL_SENSE.SchDoc, HYDRA_REGULATORS.SchDoc, HYDRA_V3_POWER.PrjPcb, HYDRA_V3_POWER.SchDoc, INT_REG.SchDoc, LM7310.SchDoc, MOSFET_JUNCTION.SchDoc, PWR_PROT.SchDoc]
2024-12-22 added load sharing to hydra pwr, still need to put proper component sizes in it though
    [HYDRA_REGULATORS.SchDoc, HYDRA_V3_POWER.SchDoc, LM7310.SchDoc, STM32G473CET6_PINOUT.SchDoc]
2024-12-29 started layout of power board
    [CELL_SENSE.SchDoc, HYDRA_REGULATORS.SchDoc, HYDRA_V3_POWER.PrjPcb, HYDRA_V3_POWER.SchDoc, INT_REG.SchDoc, LM7310.SchDoc, MOSFET_JUNCTION.SchDoc, PWR_PROT.SchDoc]
2025-01-01 I'm cooking on V4 power, still gotta rename the folders
    [HYDRA_V3_POWER.PrjPcb, HYDRA_V3_POWER.SchDoc, INT_REG.SchDoc, MOSFET_JUNCTION.SchDoc, PWR_PROT.SchDoc, STM32G473CET6_PINOUT.SchDoc]
2025-01-02 renamed relevant boards to V4
    [CELL_SENSE.SchDoc, EJECTION_CIRCUIT.SchDoc, GPS.SchDoc, HYDRA_REGULATORS.SchDoc, HYDRA_V3_NAV.PrjPcb, HYDRA_V3_POWER.PrjPcb, HYDRA_V3_POWER.SchDoc, HYDRA_V4_NAV.PrjPcb]
2025-01-03 lots of work
    [BATT_MGMT.SchDoc, CELL_SENSE.SchDoc, GPS.SchDoc, HYDRA_V4_LINK.PcbDoc, HYDRA_V4_LINK.PrjPcb, HYDRA_V4_LINK.SchDoc, HYDRA_V4_POWER.SchDoc, OC_PROT.SchDoc]
2025-01-03 lotsa work
    [BATT_MGMT.SchDoc, RFD_PWR_MGMT.SchDoc]
2025-01-04 link is cooking
    [BATT_MGMT.SchDoc, GPS.SchDoc, HYDRA_V4_LINK.PrjPcb, HYDRA_V4_LINK.SchDoc, OC_PROT.SchDoc, RADIO.SchDoc, RFD_PWR_MGMT.SchDoc, SD.SchDoc]
2025-01-04 started work on adding camera if to v4 recovery
    [CAMERA_INTERFACE.SchDoc, HYDRA_V3_CAMERA.PrjPcb, HYDRA_V4_RECOVERY.PrjPcb, HYDRA_V4_RECOVERY.SchDoc, IMU.SchDoc, OC_PROT.SchDoc, SAME51_PINOUT.SchDoc, STM32G473CET6_PINOUT.SchDoc]
2025-01-05 recovery layout could be better and need to refactor OC prot to add I sense to all boards
    [ACTUATOR_PWR_PROT.SchDoc, CAMERA_INTERFACE.SchDoc, EJECTION_CIRCUIT.SchDoc, HYDRA_V3_RECOVERY.PrjPcb, HYDRA_V3_RECOVERY.SchDoc, HYDRA_V4_NAV.PrjPcb, HYDRA_V4_RECOVERY.PrjPcb, HYDRA_V4_RECOVERY.SchDoc]
2025-01-06 started actuator board and almost done v4 rec but maybe camera layout can be less obnoxious and I need to update the OC prot to use new IC once I have 2 monitors again
    [EJECTION_CIRCUIT.SchDoc, HYDRA_V4_ACTUATOR.PrjPcb, HYDRA_V4_ACTUATOR.SchDoc, HYDRA_V4_RECOVERY.PrjPcb, HYDRA_V4_RECOVERY.SchDoc, INT_REG.SchDoc, PWR_MGMT.SchDoc, STM32G473CET6_PINOUT.SchDoc]
2025-01-11 updating post vacay :)
    [5V_REG.SchDoc, ACT_REG.SchDoc, HYDRA_V3_POWER.PrjPcb, HYDRA_V4_ACTUATOR.PrjPcb, HYDRA_V4_ACTUATOR.SchDoc, HYDRA_V4_POWER.PrjPcb, INT_REG.SchDoc, PWR_MGMT.SchDoc]
2025-01-30 idk what changed but smthn did
    [HYDRA_V3_POWER.PrjPcb]
2025-02-14 refactoring V4 NAV
    [ACTUATOR_PWR_PROT.SchDoc, GPS.SchDoc, HYDRA_V4_NAV.PrjPcb, HYDRA_V4_NAV.SchDoc, IMU.SchDoc, OC_PROT.SchDoc, SD.SchDoc, STM32H730_PINOUT.SchDoc]
2025-02-15 worked a tiny bit on NAV, probably gonna refactor layout, I can do better
    [STM32H730_PINOUT.SchDoc]
2025-02-16 worked a bit on nav
    [GPS.SchDoc, HYDRA_V4_NAV.SchDoc]
2025-02-17 almost done nav
    [HYDRA_V4_NAV.PrjPcb, HYDRA_V4_NAV.SchDoc, IMU.SchDoc, STM32H730_PINOUT.SchDoc]
2025-02-19 moved on to reworking V4 link
    [BATT_MGMT.SchDoc, ETHERNET.SchDoc, HYDRA_V4_LINK.PrjPcb, HYDRA_V4_LINK.SchDoc, OC_PROT.SchDoc, STM32G473CET6_PINOUT.SchDoc]
2025-02-19 tiny bit of work on link, I think I figured out CAN_INH implementation
    [BATT_MGMT.SchDoc, GPS.SchDoc, HYDRA_V4_LINK.PrjPcb, HYDRA_V4_LINK.SchDoc]
2025-03-21 pushing to work from desktop
    [BATT_MGMT.SchDoc, HYDRA_V4_LINK.SchDoc, OC_PROT.SchDoc, RFD_PWR_MGMT.SchDoc]
2025-03-21 need to review link schematics and should be able to do final layout soon. pwr should be revised, has a lot of overly complex circuitry imo
    [BATT_MGMT.SchDoc, HYDRA_V4_LINK.SchDoc, OC_PROT.SchDoc, RADIO.SchDoc, RFD_PWR_MGMT.SchDoc]
2025-03-24 lots of work on link schematics
    [BATT_MGMT.SchDoc, ETHERNET.SchDoc, HYDRA_V4_LINK.PrjPcb, HYDRA_V4_LINK.SchDoc, OC_PROT.SchDoc, RADIO.SchDoc, RFD_PWR_MGMT.SchDoc, SD.SchDoc]
2025-03-26 almost done refactoring v4 link MCU schematic
    [HYDRA_V4_LINK.SchDoc, OC_PROT.SchDoc, STM32G473CET6_PINOUT.SchDoc, STM32G473RET6_PINOUT.xlsx]
2025-03-29 halfway thru working on link layout
    [BATT_MGMT.SchDoc, ETHERNET.SchDoc, HYDRA_V4_LINK.PrjPcb, HYDRA_V4_LINK.SchDoc, OC_PROT.SchDoc, RFD_PWR_MGMT.SchDoc, STM32G473CET6_PINOUT.SchDoc, STM32G473RET6_PINOUT.xlsx]
2025-03-30 almost done hydra v4 link layout, still missing red pwr led mosfet integration in schematics tho
    [BATT_MGMT.SchDoc, ETHERNET.SchDoc, HYDRA_V4_LINK.SchDoc, OC_PROT.SchDoc, RFD_PWR_MGMT.SchDoc, STM32G473RET6_PINOUT.xlsx]
2025-04-02 link is hella populated, there are a few GPIOs left but trace width all around (excluding power traces) should be reduced to .15mm or less
    [BATT_MGMT.SchDoc, HYDRA_V4_LINK.PrjPcb, HYDRA_V4_LINK.SchDoc, OC_PROT.SchDoc, RADIO.SchDoc, RFD_PWR_MGMT.SchDoc, STM32G473RET6_PINOUT.xlsx, TCAN1146_PINOUT.SchDoc]
2025-04-04 uploading to work on desktop
    [HYDRA_V4_LINK.SchDoc, RFD_PWR_MGMT.SchDoc, RP_AND_SAFETYSW.SchDoc, STM32G473RET6_PINOUT.xlsx]
2025-04-04 updated a bit of v4 power
    [HYDRA_V4_POWER.PrjPcb, HYDRA_V4_POWER.SchDoc, INT_REG.SchDoc, MOSFET_JUNCTION.SchDoc, RP_AND_SAFETYSW.SchDoc, STM32G473CET6_PINOUT.SchDoc, STM32G473RET6_PINOUT.SchDoc, STM32G473RET6_PINOUT.xlsx]
2025-04-05 started correcting/simplifying V4 pwr
    [HYDRA_REGULATORS.SchDoc, HYDRA_V4_POWER.PrjPcb, HYDRA_V4_POWER.SchDoc, INT_REG.SchDoc, LM7310.SchDoc, MOSFET_JUNCTION.SchDoc, PWR_PROT.SchDoc, RP_AND_SAFETYSW.SchDoc]
2025-04-06 done correcting power, onto layout update
    [CELL_SENSE.SchDoc, HYDRA_REGULATORS.SchDoc, HYDRA_V4_POWER.PrjPcb, HYDRA_V4_POWER.SchDoc, MOSFET_JUNCTION.SchDoc, PWR_PROT.SchDoc, RP_AND_SAFETYSW.SchDoc, STM32G473CET6_PINOUT.SchDoc]
2025-04-08 halfway thru layout of v4 power
    [HYDRA_V4_POWER.SchDoc, MOSFET_JUNCTION.SchDoc, PWR_PROT.SchDoc, RP_AND_SAFETYSW.SchDoc, TCAN1146_PINOUT.SchDoc]
2025-04-09 power is cooooookin
    [CELL_SENSE.SchDoc, HYDRA_REGULATORS.SchDoc, HYDRA_V4_POWER.SchDoc, MOSFET_JUNCTION.SchDoc, PG_MUX.SchDoc, PWR_PROT.SchDoc, RP_AND_SAFETYSW.SchDoc, STM32G473RET6_PINOUT.SchDoc]
2025-04-10 ready to start pinning v4 power MCU
2025-04-11 v4 power layout is almost done, rst and a 3v3 line is left to be routed and then DRC
    [CELL_SENSE.SchDoc, HYDRA_V4_POWER.SchDoc, STM32G473RET6_PINOUT.SchDoc, STM32G473RET6_PINOUT.xlsx]
2025-04-13 finished v4 power and started finishing v4 recovery schematics. need to switch connectors to JST GH 1.25 now (not using picoblade)
    [CAMERA_INTERFACE.SchDoc, EJECTION_CIRCUIT.SchDoc, HYDRA_V4_POWER.PrjPcb, HYDRA_V4_POWER.SchDoc, HYDRA_V4_RECOVERY.PrjPcb, HYDRA_V4_RECOVERY.SchDoc, OC_PROT.SchDoc, SAFETY_SWITCH.SchDoc]
2025-04-14 did a lil more
    [HYDRA_V4_RECOVERY.SchDoc]
2025-04-15 recovery layout nearing completion, need to connect MCU
    [HYDRA_V4_RECOVERY.PrjPcb, HYDRA_V4_RECOVERY.SchDoc, OC_PROT.SchDoc, SD.SchDoc, SENSOR_BANK.SchDoc, STM32H730_PINOUT.SchDoc]
2025-04-16 working on recovery layout
    [CELL_SENSE.SchDoc, HYDRA_V4_POWER.SchDoc, HYDRA_V4_RECOVERY.SchDoc]
2025-04-17 progressed on recovery
    [HYDRA_V4_RECOVERY.SchDoc, OC_PROT.SchDoc, STM32H730_PINOUT.SchDoc, STM32H730_PINOUT.xlsx]
2025-04-18 worked on recovery and started MBA project for V4 boards
    [CAMERA_INTERFACE.SchDoc, HYDRA_V4_RECOVERY.SchDoc, STM32H730_PINOUT.SchDoc, STM32H730_PINOUT.xlsx, TCAN330_PINOUT.SchDoc]
2025-04-19 working to finalize boards now, NAV needs rework and logo/LED/test placement as well as outline needs to be homogenized across boards
    [CAMERA_INTERFACE.SchDoc, CELL_SENSE.SchDoc, HYDRA_V4_LINK.SchDoc, HYDRA_V4_NAV.SchDoc, HYDRA_V4_POWER.PrjPcb, HYDRA_V4_POWER.SchDoc, HYDRA_V4_RECOVERY.PrjPcb, HYDRA_V4_RECOVERY.SchDoc]
2025-04-19 pretty much done development, good to start review. it's not perfect, but it needs to get ordered
    [HYDRA_V4_LINK.SchDoc, HYDRA_V4_RECOVERY.SchDoc, SD.SchDoc, STM32H730_PINOUT.xlsx]
2025-04-20 V4 NAV corrected, need to check GPS trace impedance and flip pin1 marking on GPS footprint. rest seems ok
    [ACTUATOR_PWR_PROT.SchDoc, GPS.SchDoc, HYDRA_V4_NAV.PrjPcb, HYDRA_V4_NAV.SchDoc, IMU.SchDoc, OC_PROT.SchDoc, SD.SchDoc, STM32H730_PINOUT.SchDoc]
2025-04-21 corrected v4 recovery. v4 power and link left and need to homogenize led/silkscreen object positions
    [CAMERA_INTERFACE.SchDoc, HYDRA_V4_RECOVERY.SchDoc, SENSOR_BANK.SchDoc, STM32H730_PINOUT.SchDoc]
2025-04-22 corrected power, need to wire up a pin on recovery and correct link + homogenization
    [CAMERA_INTERFACE.SchDoc, CELL_SENSE.SchDoc, HYDRA_REGULATORS.SchDoc, HYDRA_V4_POWER.PrjPcb, HYDRA_V4_POWER.SchDoc, HYDRA_V4_RECOVERY.PrjPcb, HYDRA_V4_RECOVERY.SchDoc, LM7310.SchDoc]
2025-04-23 worked on homogenization, found issues with TCAN1146 implementation and need to figure out LINK
    [ACTUATOR_PWR_PROT.SchDoc, CAMERA_INTERFACE.SchDoc, HYDRA_V4_LINK.SchDoc, HYDRA_V4_NAV.PrjPcb, HYDRA_V4_NAV.SchDoc, HYDRA_V4_RECOVERY.SchDoc, IMU.SchDoc, OC_PROT.SchDoc]
2025-04-24 holy fuck i need a break
    [BATT_MGMT.SchDoc, HYDRA_V4_LINK.PrjPcb, HYDRA_V4_LINK.SchDoc, OC_PROT.SchDoc, RFD_PWR_MGMT.SchDoc, TCAN1146_PINOUT.SchDoc]
2025-04-24 I think V4 is done, need to make sure components are homogenized and review boards quickly once again. fix trace impedance on NAV GPS
    [CELL_SENSE.SchDoc, ETHERNET.SchDoc, GPS.SchDoc, HYDRA_V4_LINK.PrjPcb, HYDRA_V4_LINK.SchDoc, HYDRA_V4_NAV.SchDoc, PWR_PROT.SchDoc, STM32G473CET6_PINOUT.SchDoc]
2025-04-25 ordered v4 boards, sick of looking at them in altium and wanna test irl
    [Bill of Materials-HYDRA_V4_LINK.xlsx, HYDRA_V4_LINK.PrjPcb, HYDRA_V4_LINK.SchDoc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]
2025-04-27 added some CAD files for L1L2 integration
    [1.SLDASM, 1.SLDPRT, 150066xx54050.SLDASM, 1_2.SLDPRT, 1_3.SLDPRT, 1_4.SLDPRT, 1_5.SLDPRT, 2.SLDPRT]
2025-04-28 did some CAD work on L1L2 rckt
    [Body1.SLDPRT, Body2.SLDPRT, HYDCRDL_LFT.STL, HYDCRDL_RIG.STL, HYDRA_CRADDLE_TOP_COVER.SLDPRT, HYDRA_CRADDLE_TOP_COVER.STL, ROCKET_BATTERY_CONTAINER.SLDPRT, ROCKET_BATTERY_CONTAINER.STL]
2025-04-30 updated some stl files
    [ROCKET_RECOVERY_CHARGE_HOLDER.SLDPRT, ROCKET_RECOVERY_CHARGE_HOLDER.STL]
2025-07-29 started consulting deepseek for vibecoding purposes
    [STM32H730_PINOUT.SchDoc]
2025-09-05 updated BOM stuff
    [ACTUATOR_PWR_PROT.SchDoc, BATT_MGMT.SchDoc, CAMERA_INTERFACE.SchDoc, CELL_SENSE.SchDoc, EJECTION_CIRCUIT.SchDoc, ETHERNET.SchDoc, GPS.SchDoc, HYDRA_REGULATORS.SchDoc]
2025-09-30 started CAD of second L1L2 rocket
    [1.SLDASM, 1.SLDPRT, 150066xx54050.SLDASM, 1_2.SLDPRT, 1_3.SLDPRT, 1_4.SLDPRT, 1_5.SLDPRT, 2.SLDPRT]
2025-10-01 worked on L1L2 rocket CAD
    [COTS_CAMERA_MODULE.SLDPRT, COTS_EYE_BOLT.SLDPRT, COTS_WASHER_3_16.SLDPRT, HYDRA_CRADDLE.SLDPRT, HYDRA_GPS_ANTENNA.SLDPRT, HYDRA_LORA_MODULE.SLDPRT, HYDRA_STUBBY_433_ANTENNA.SLDPRT, ROCKET_BODY_COUPLER.SLDPRT]
2025-10-01 l1l2 rocket CAD is almost done
    [COTS_EYE_BOLT.SLDPRT, COTS_WASHER_3_16.SLDPRT, HYDRA_CRADDLE.SLDPRT, HYDRA_UMBILICAL_COVER.SLDPRT, ROCKET_BAFFLE_PLATE.SLDPRT, ROCKET_BAFFLE_TUBE.SLDPRT, ROCKET_BODY_TUBE_LOWER.SLDPRT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]
2025-10-03 done l1l2 rocket CAD but stability seems a hair high
    [COTS_BARREL_JACK_FOR_RBF.SLDPRT, COTS_METAL_M3_STANDOFF.SLDPRT, HYDRA_CAMERA_COVER.SLDPRT, HYDRA_CRADDLE.SLDPRT, HYDRA_CRADDLE.STL, HYDRA_PCB_CLAMP.SLDPRT, HYDRA_UMBILICAL_COVER.SLDPRT, ROCKET_BODY_TUBE_LOWER.SLDPRT]
